MPstoughton/HB-Drive/HB_Drive_V1/Custom Components/54-00164/54-00164.step

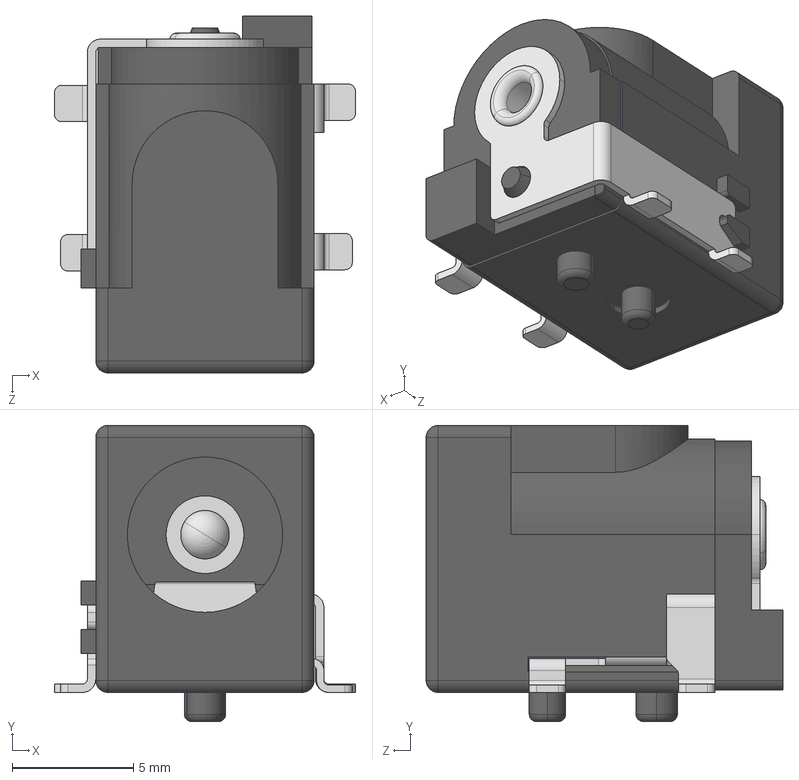
[picture p1: CAD file, 2026-06-23]
HB_Drive_V1/Custom Components/54-00164/54-00164.step
12.4 x 12.2 x 14.7 mm
