MPstoughton/HB-Drive/HB_Drive_V1/Custom Components/MMBD914LT3G/SOT-23_ONS.step

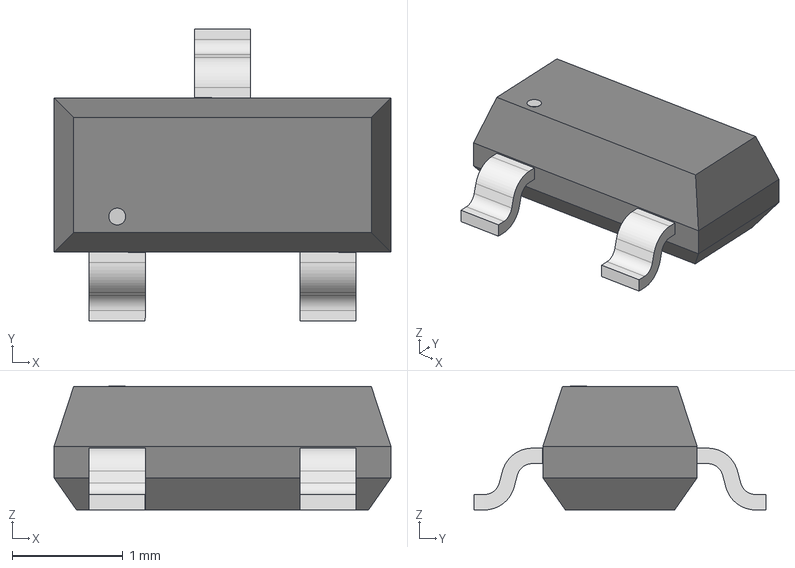
[picture p2: CAD file, 2026-06-23]
HB_Drive_V1/Custom Components/MMBD914LT3G/SOT-23_ONS.step
3.05 x 2.64 x 1.12 mm
