MPstoughton/HB-Drive/HB_Drive_V1/Custom Components/PTS636SL43SMTRLFS/PTS636SL43SMTRLFS.step

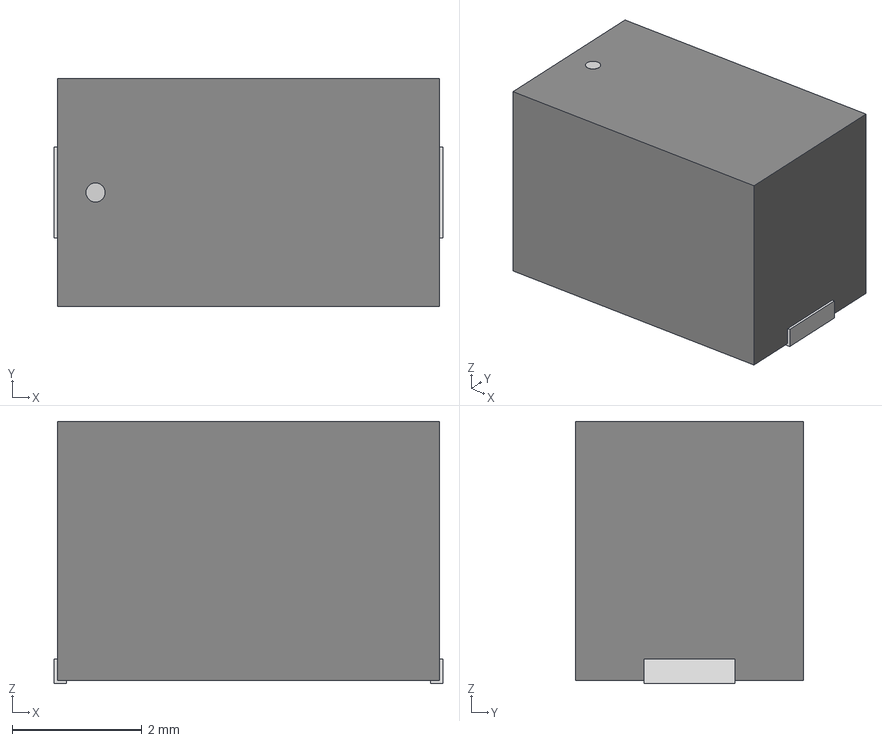
[picture p3: CAD file, 2026-07-07]
HB_Drive_V1/Custom Components/PTS636SL43SMTRLFS/PTS636SL43SMTRLFS.step
5.99 x 3.51 x 4.04 mm
