MPstoughton/HB-Drive/HB_Drive_V1/Custom Components/PV36W103C01B00/POT_PV36W_BRN.step

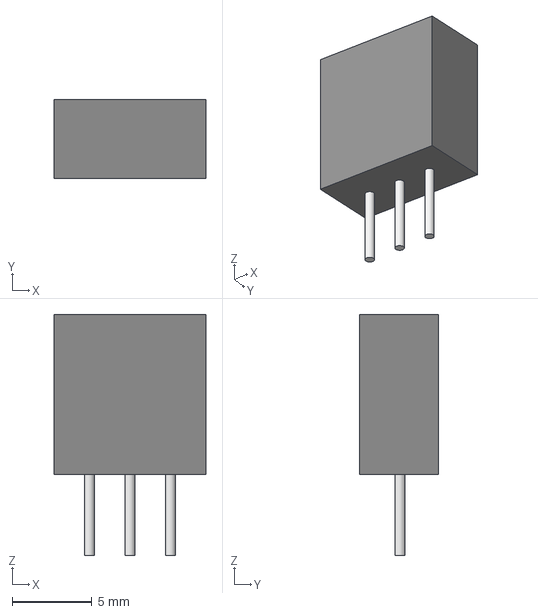
[picture p4: CAD file, 2026-06-23]
HB_Drive_V1/Custom Components/PV36W103C01B00/POT_PV36W_BRN.step
9.52 x 4.95 x 15.1 mm
