MPstoughton/HB-Drive/HB_Drive_V1/Custom Components/PV36W104C01B00/POT_PV36W_BRN.step

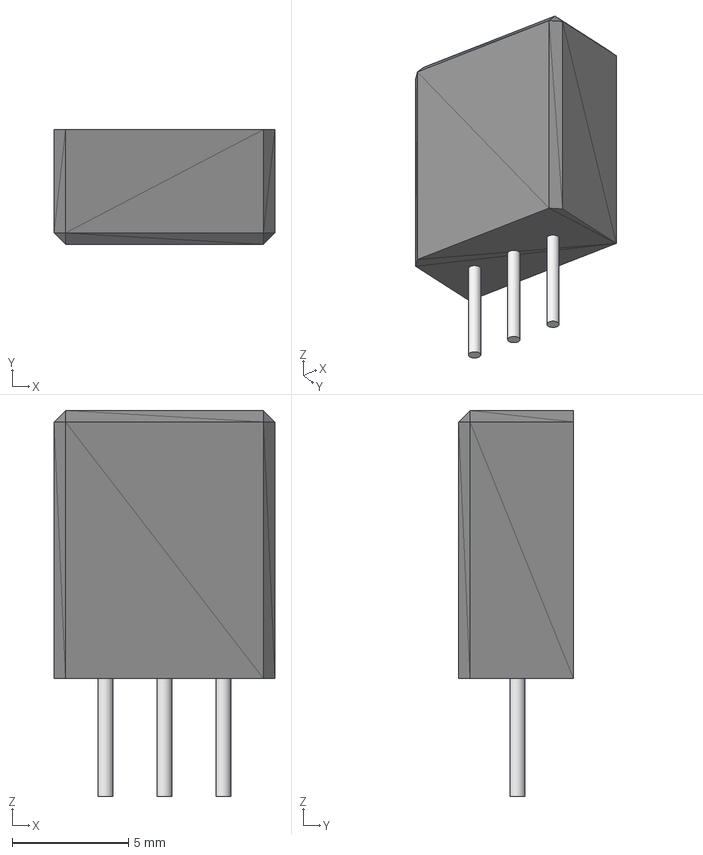
[picture p5: CAD file, 2026-06-12]
HB_Drive_V1/Custom Components/PV36W104C01B00/POT_PV36W_BRN.step
9.52 x 4.95 x 16.6 mm
