MPstoughton/HB-Drive/HB_Drive_V1/Custom Components/R_78E5_0_0_5/R_78E5_0_0_5.stp

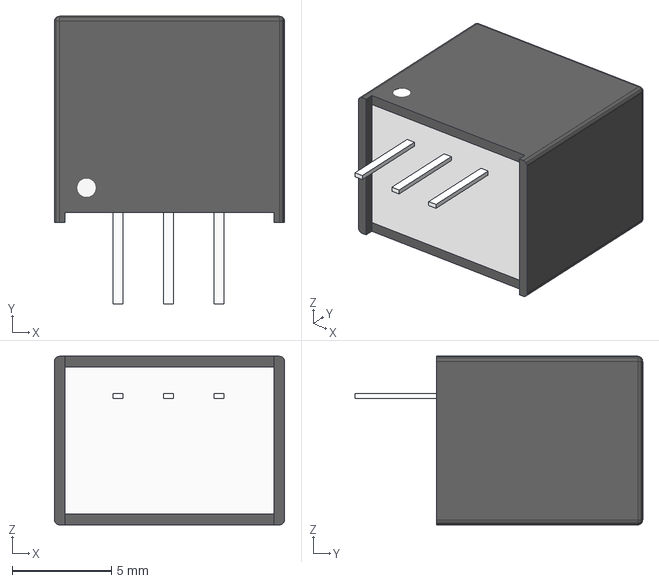
[picture p6: CAD file, 2026-07-03]
HB_Drive_V1/Custom Components/R_78E5_0_0_5/R_78E5_0_0_5.stp
11.6 x 14.5 x 8.51 mm
