MPstoughton/HB-Drive/HB_Drive_V1/Custom Components/TMH_0515D/tmh_single_3d_drawing.stp

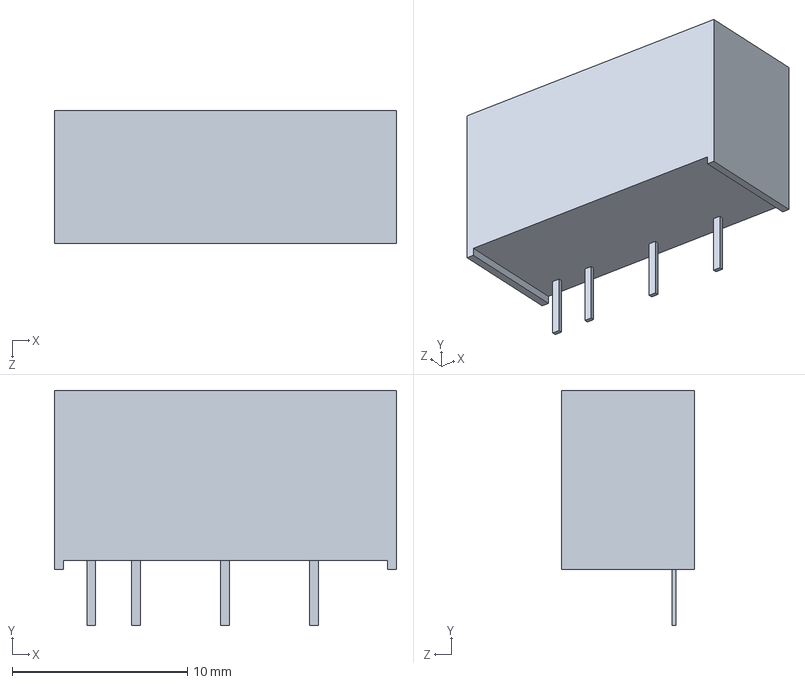
[picture p7: CAD file, 2026-07-03]
HB_Drive_V1/Custom Components/TMH_0515D/tmh_single_3d_drawing.stp
19.5 x 13.4 x 7.60 mm
