MPstoughton/HB-Drive/HB_Drive_V1/Custom Components/USB_B_S_VT/USB-B-S-VT.step

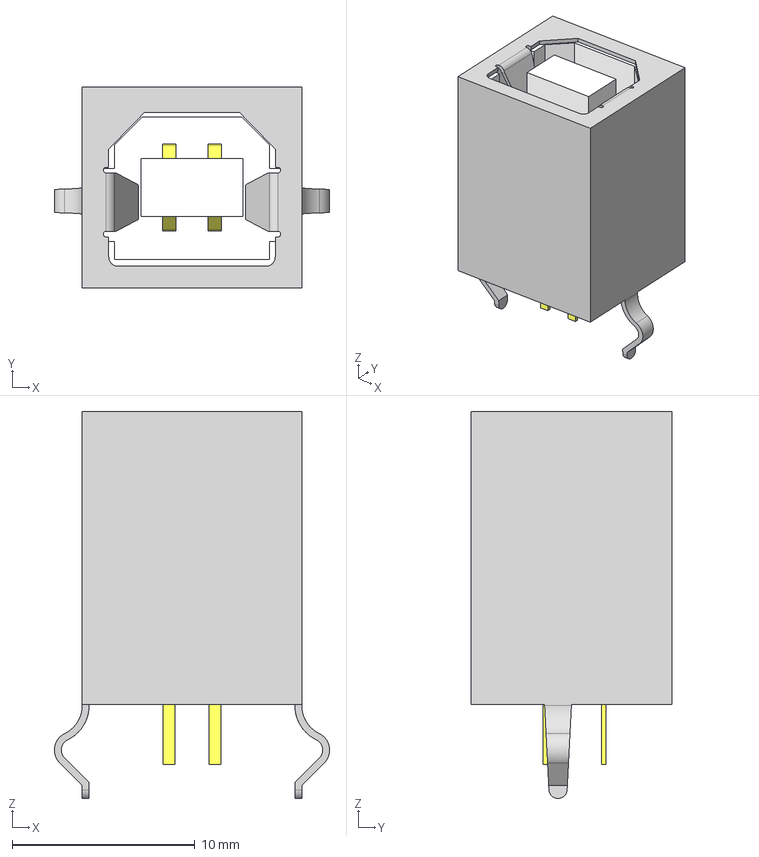
[picture p8: CAD file, 2026-07-03]
HB_Drive_V1/Custom Components/USB_B_S_VT/USB-B-S-VT.step
15.0 x 11.0 x 21.1 mm
USB-B-S-VT_S
USB-B-S-W-VT_B
USB-B-S-VT_P
