MPstoughton/HB-Drive/HB_V3_Plots/HB_Drive_V1-Edge_Cuts.dxf

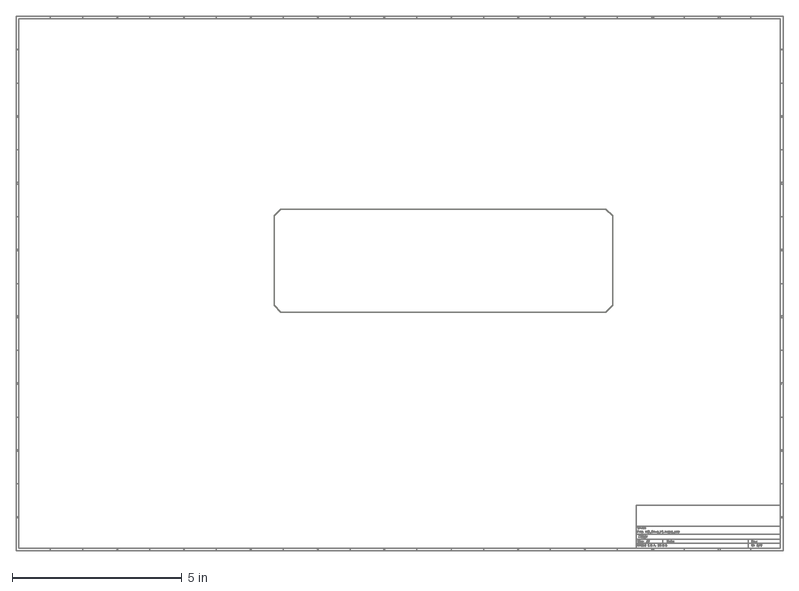
[picture p9: CAD file, 2026-10-09]
HB_V3_Plots/HB_Drive_V1-Edge_Cuts.dxf
22.6 x 15.7 in
