MPstoughton/HB-Drive/HB_Drive_V1/Custom Components/30306_6002/30306-6002HB.step

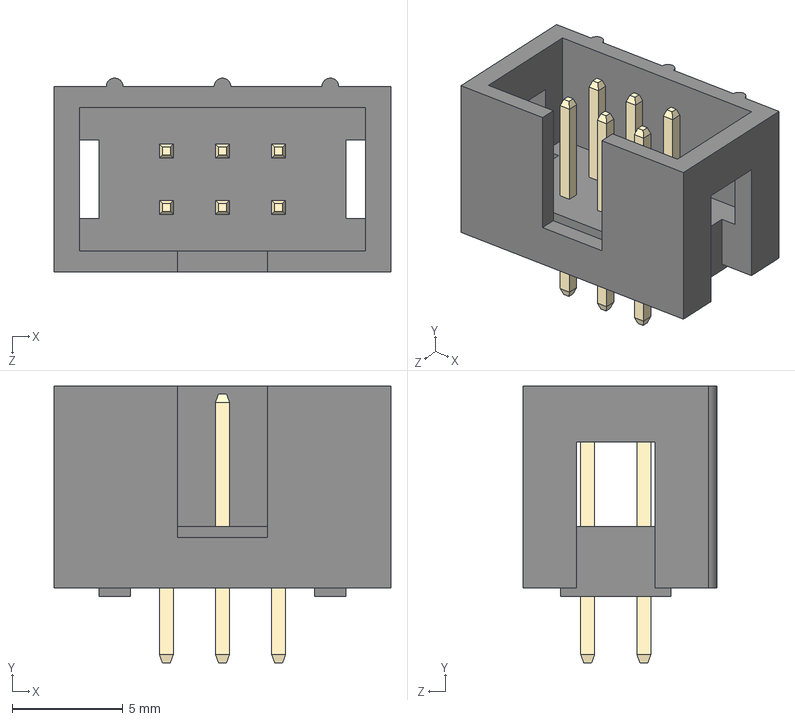
[picture p11: CAD file, 2026-08-12]
HB_Drive_V1/Custom Components/30306_6002/30306-6002HB.step
15.2 x 12.5 x 8.76 mm
