MPstoughton/HB-Drive/HB_Drive_V1/Custom Components/5227699/5227699-1.step

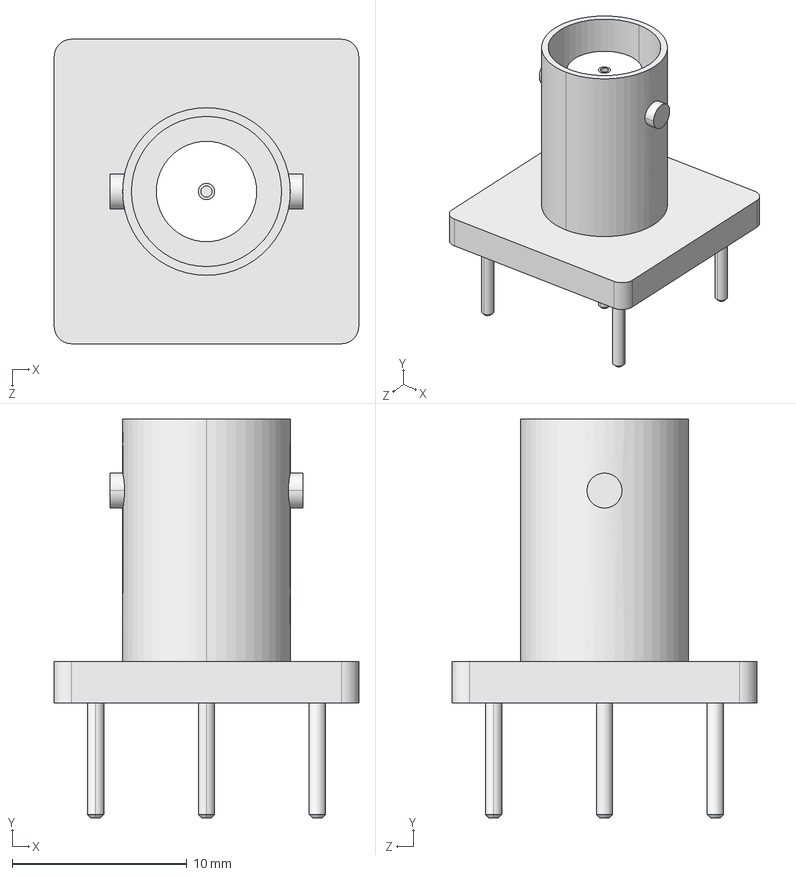
[picture p12: CAD file, 2026-07-03]
HB_Drive_V1/Custom Components/5227699/5227699-1.step
17.4 x 22.9 x 17.5 mm
