MPstoughton/HB-Drive/(list of files, cad)

Other CAD files:
HB_V3_Plots/HB_Drive_V1-F_Paste.dxf
