MPstoughton/HB-Drive/HB_Drive_V1/HB_Drive_V3.pdf

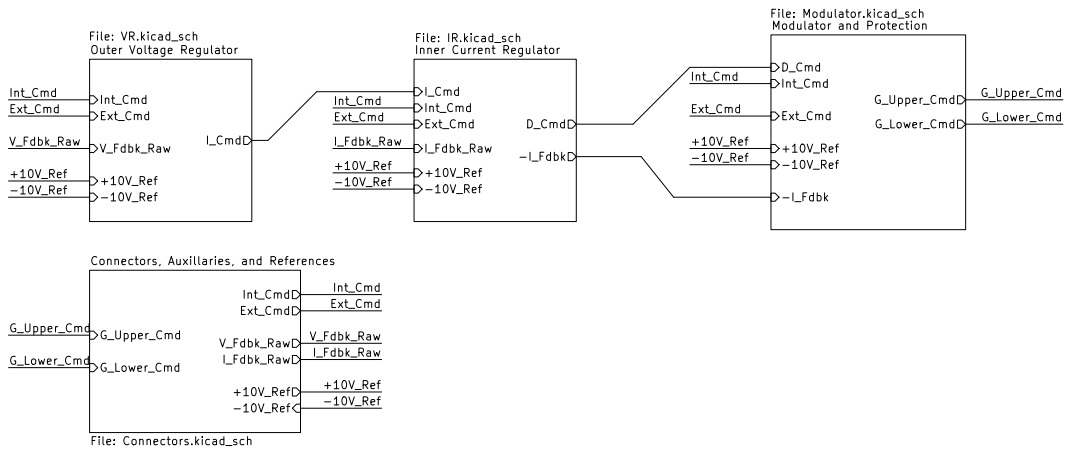
[picture p13: page 1]

Inner Current Regulator File: IR.kicad_sch

Connectors, Auxillaries, and References File: Connectors.kicad_sch

Size: A4 | Rev:
KiCad E.D.A. 10.0.5 | Id: 1/8

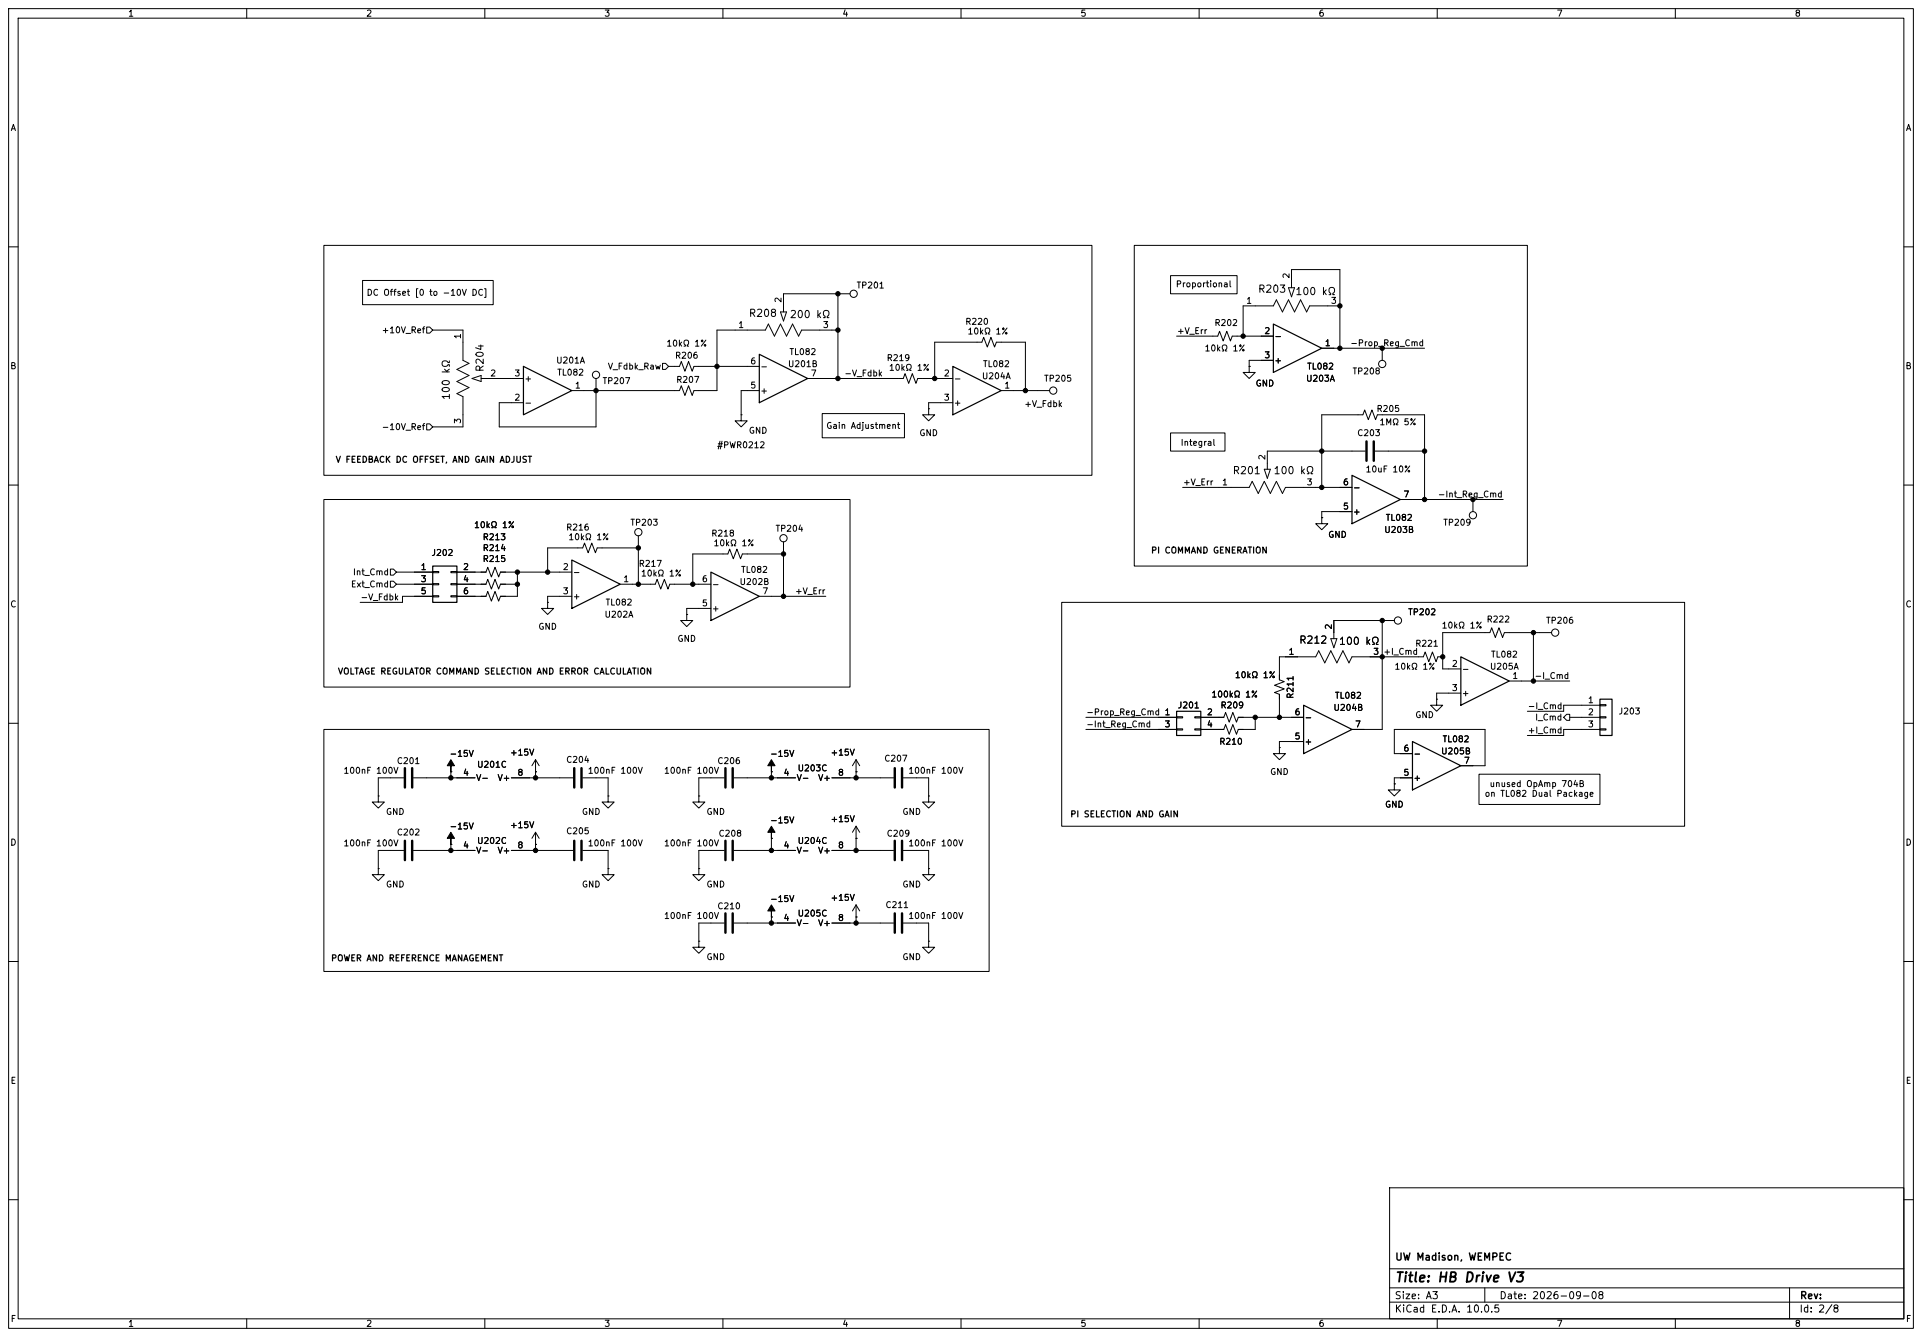
[picture p14: page 2]

Gain Adjustment VOLTAGE REGULATOR COMMAND SELECTION AND ERROR CALCULATION

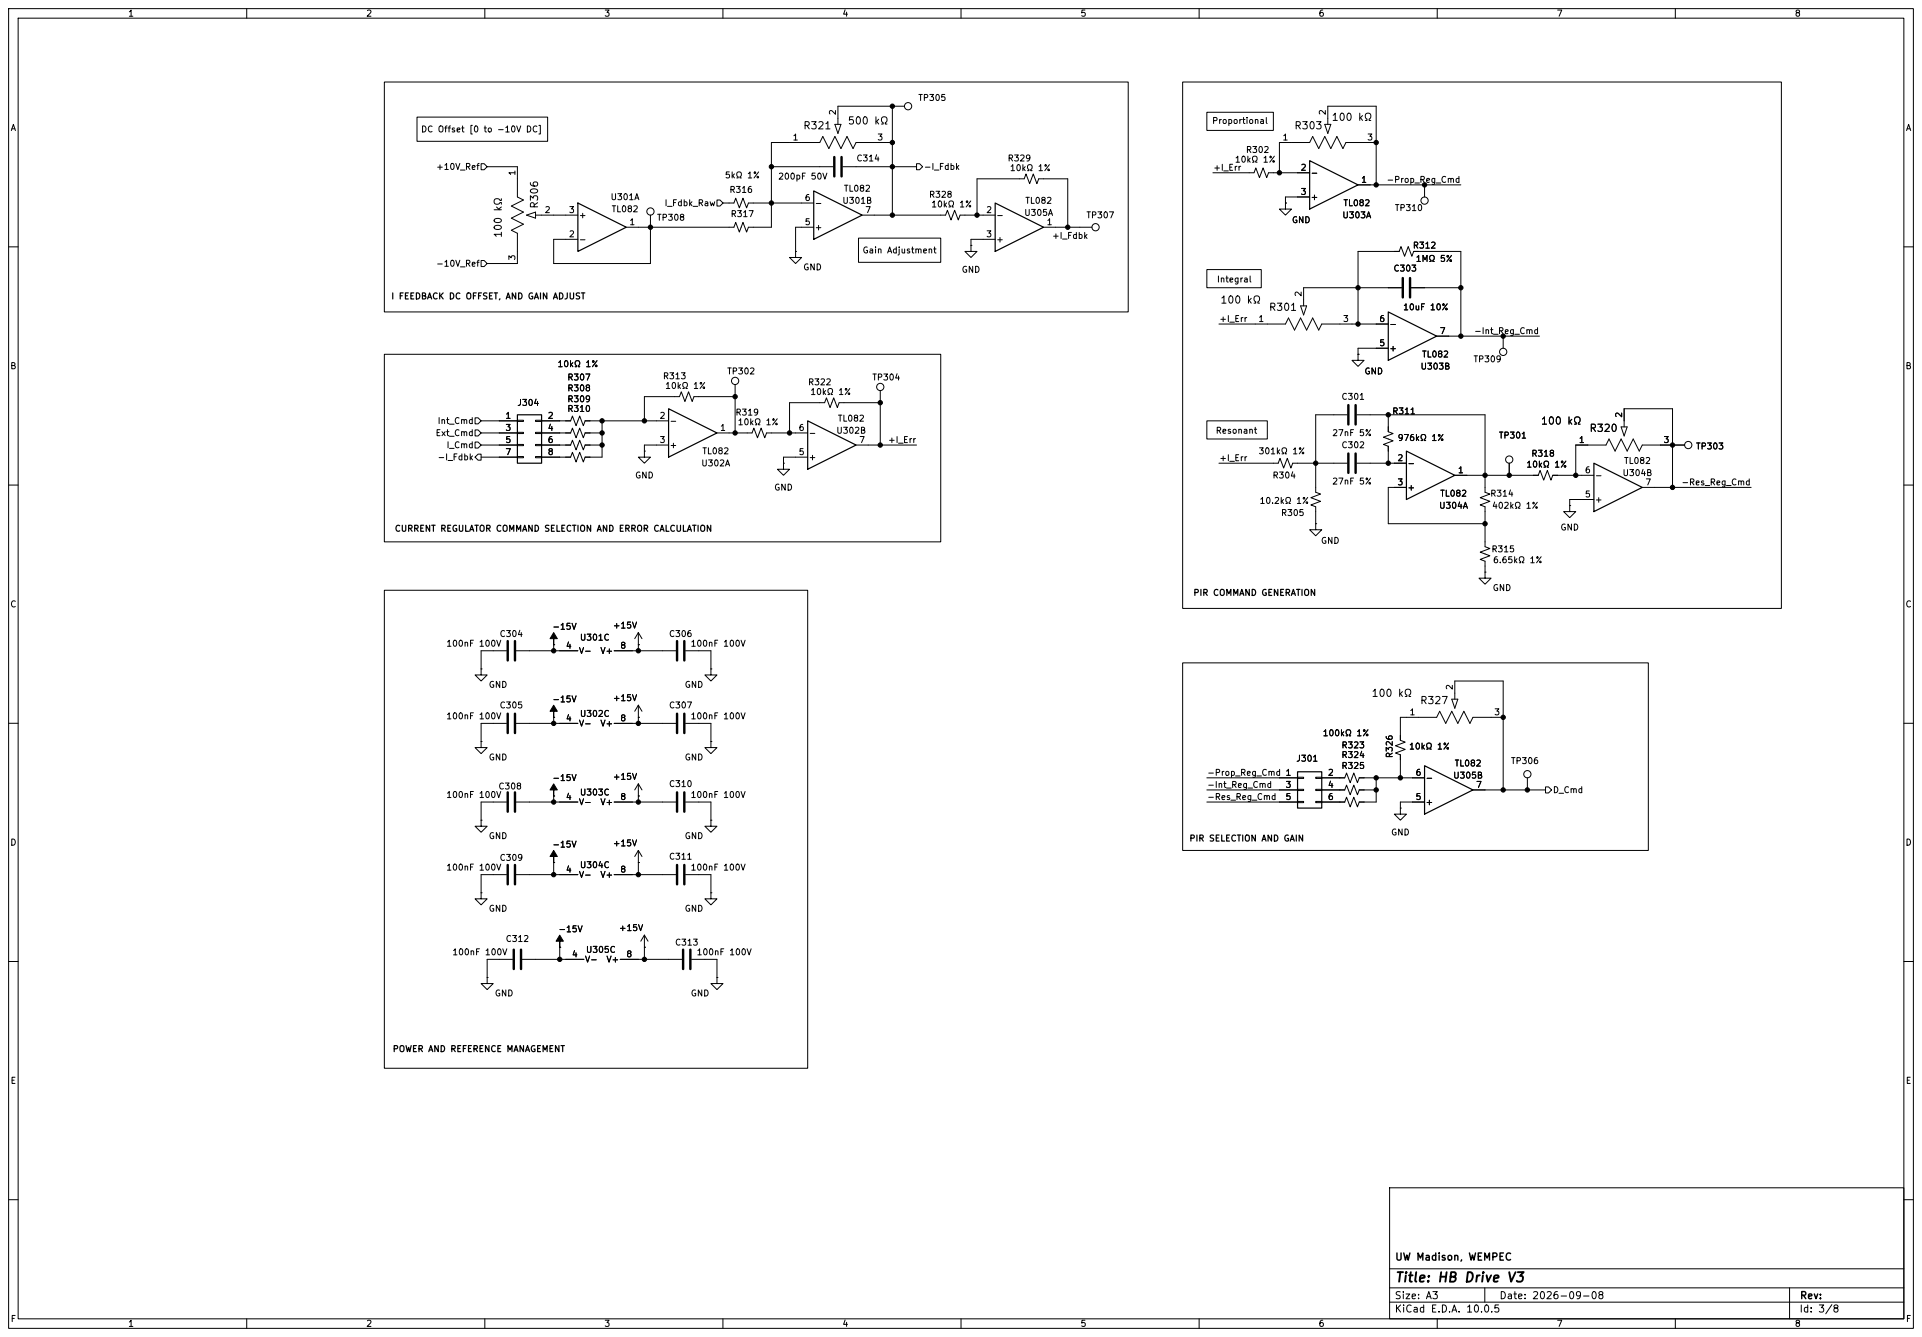
[picture p15: page 3]

Proportional DC Offset [0 to -10V DC]
-10V_Ref Ext_Cmd +10V_Ref

-Int_Reg_Cmd +I_Err +I_Err CURRENT REGULATOR COMMAND SELECTION AND ERROR CALCULATION

POWER AND REFERENCE MANAGEMENT

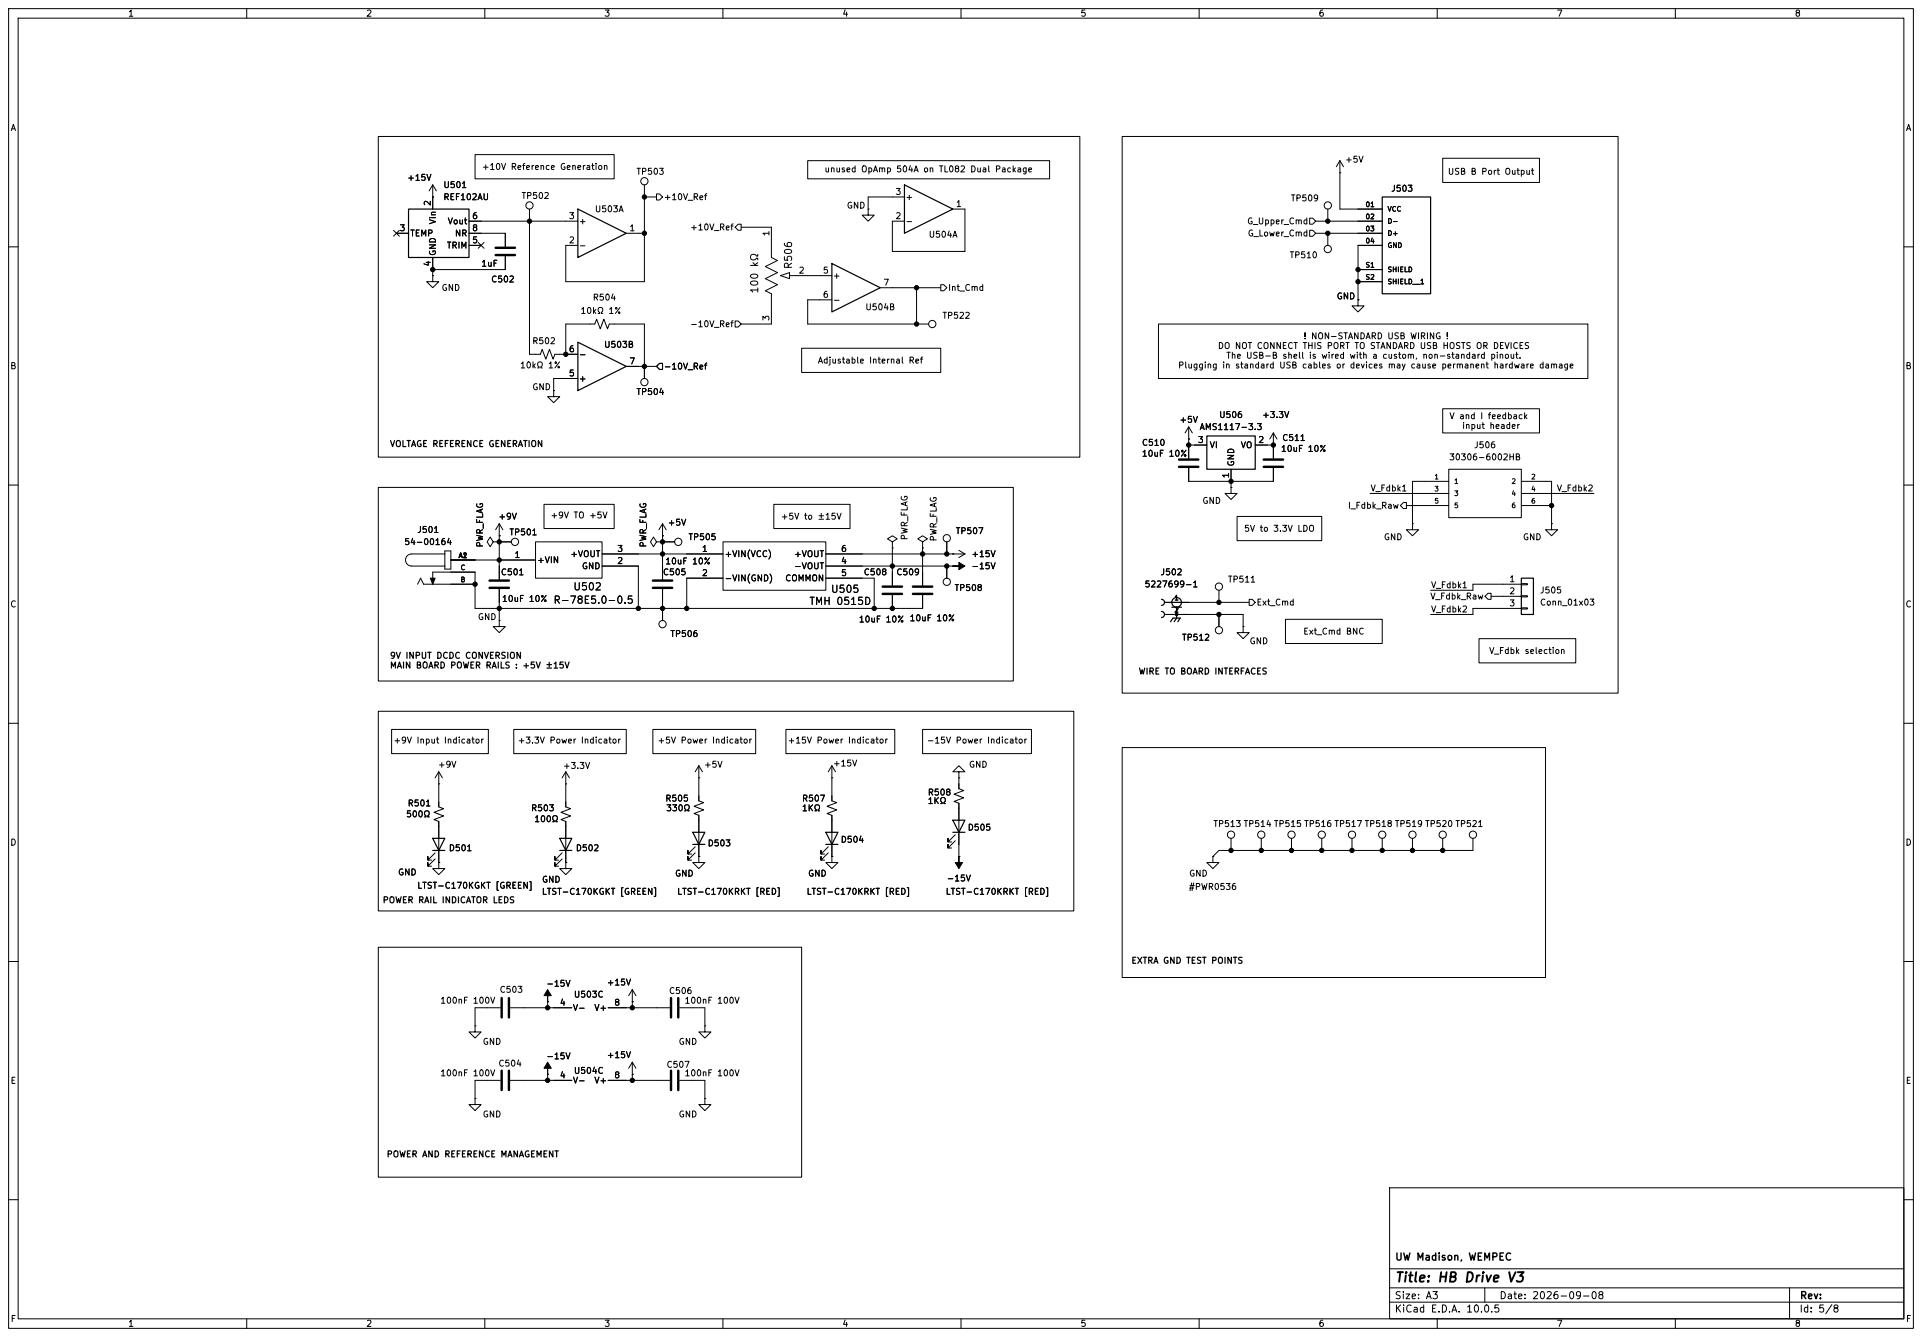
[picture p16: page 4]

9V INPUT DCDC CONVERSION MAIN BOARD POWER RAILS : +5V ±15V +10V Reference Generation +3.3V Power Indicator
U501 REF102AU Vin 2

! NON-STANDARD USB WIRING ! DO NOT CONNECT THIS PORT TO STANDARD USB HOSTS OR DEVICES

The USB-B shell is wired with a custom, non-standard pinout.

Plugging in standard USB cables or devices may cause permanent hardware damage

EXTRA GND TEST POINTS

POWER AND REFERENCE MANAGEMENT

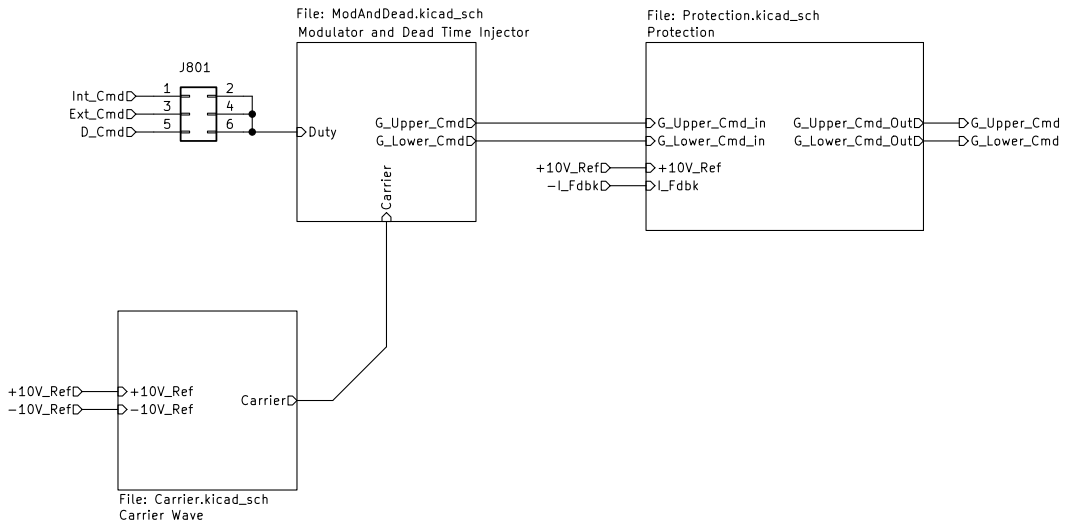
[picture p17: page 5]

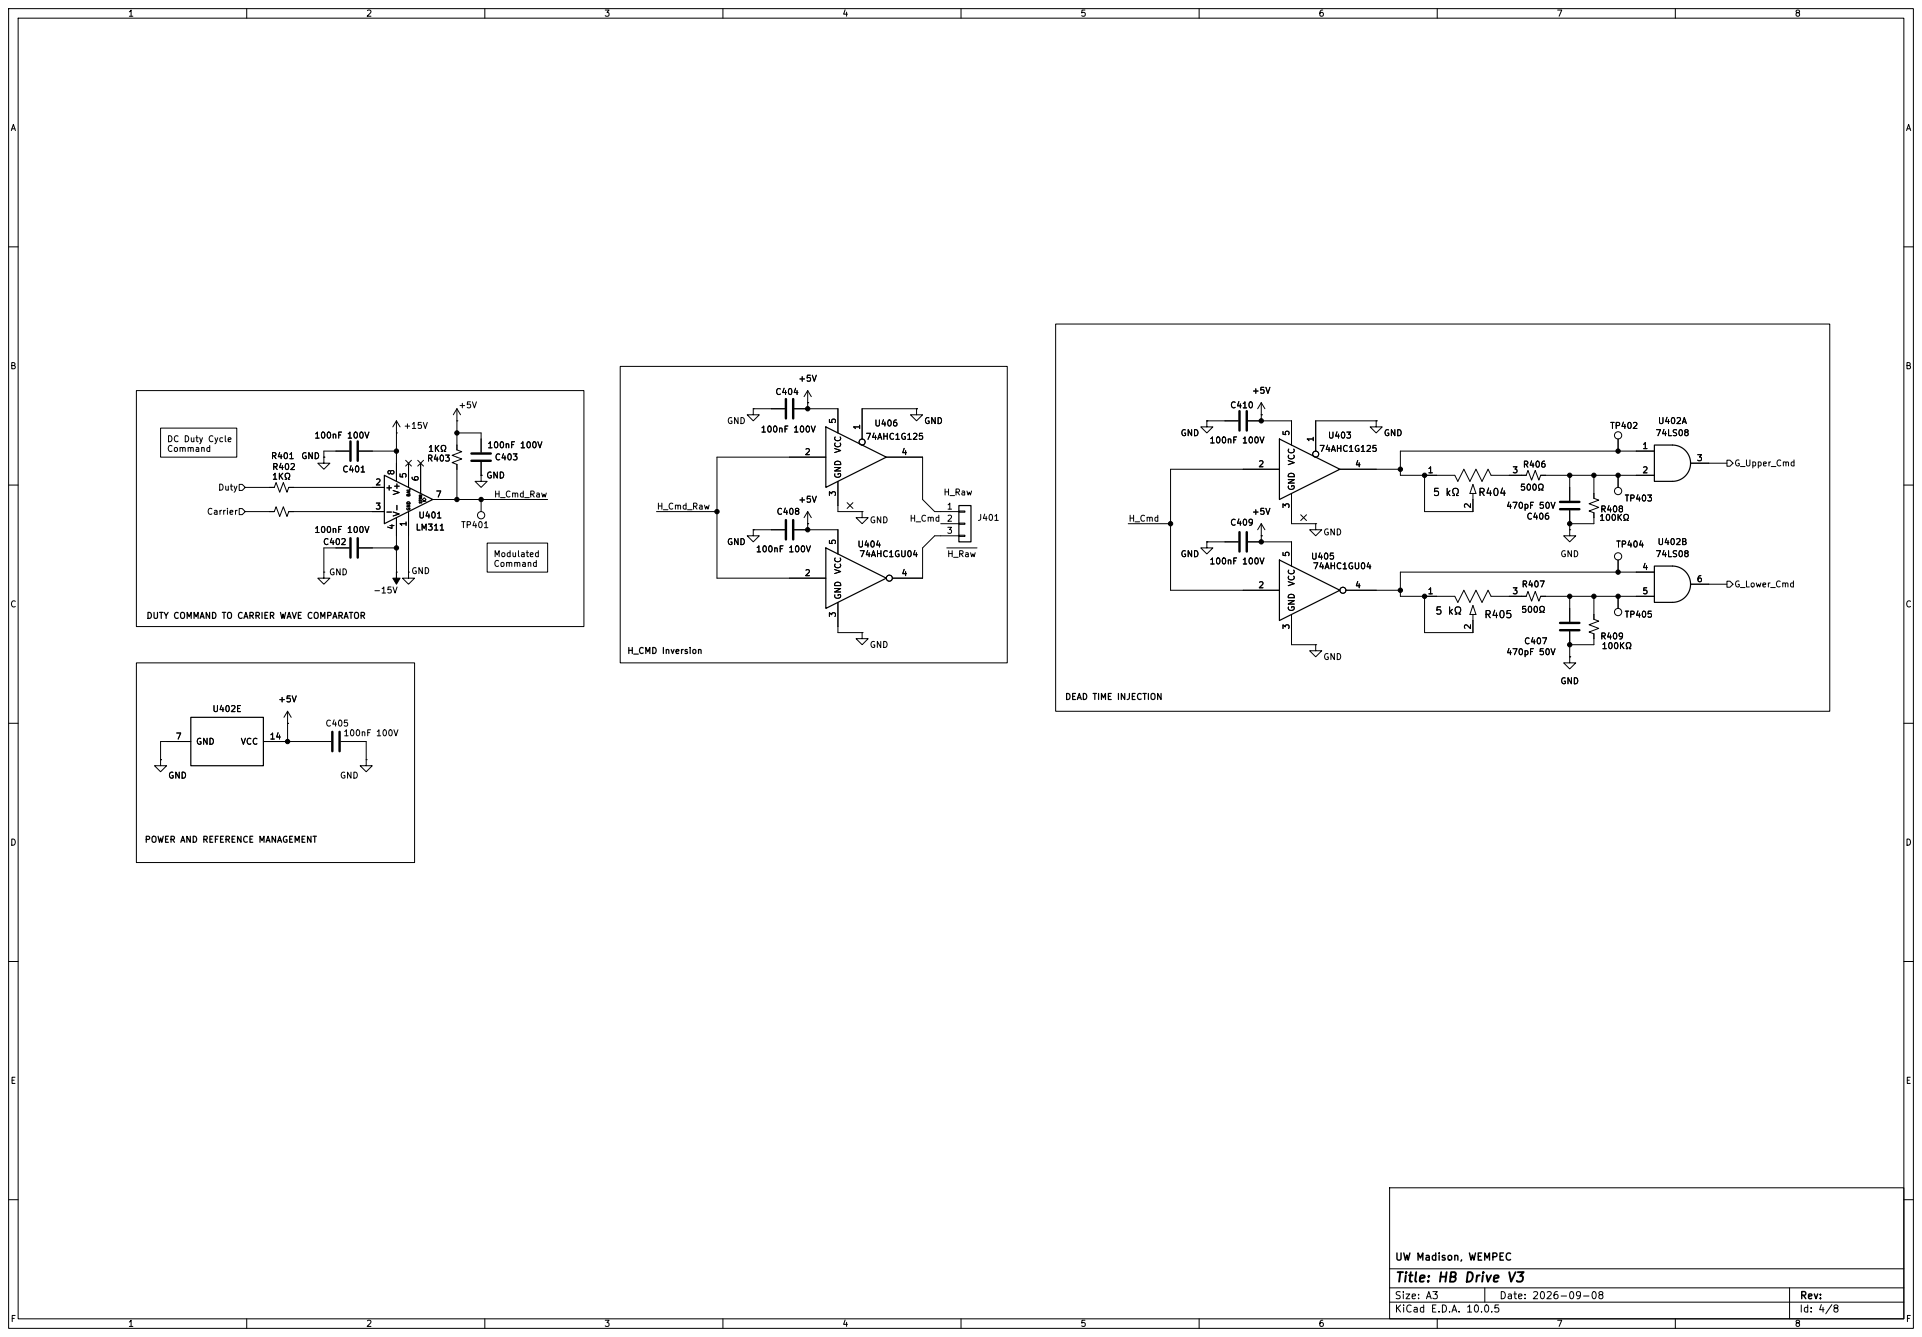
[picture p18: page 6]

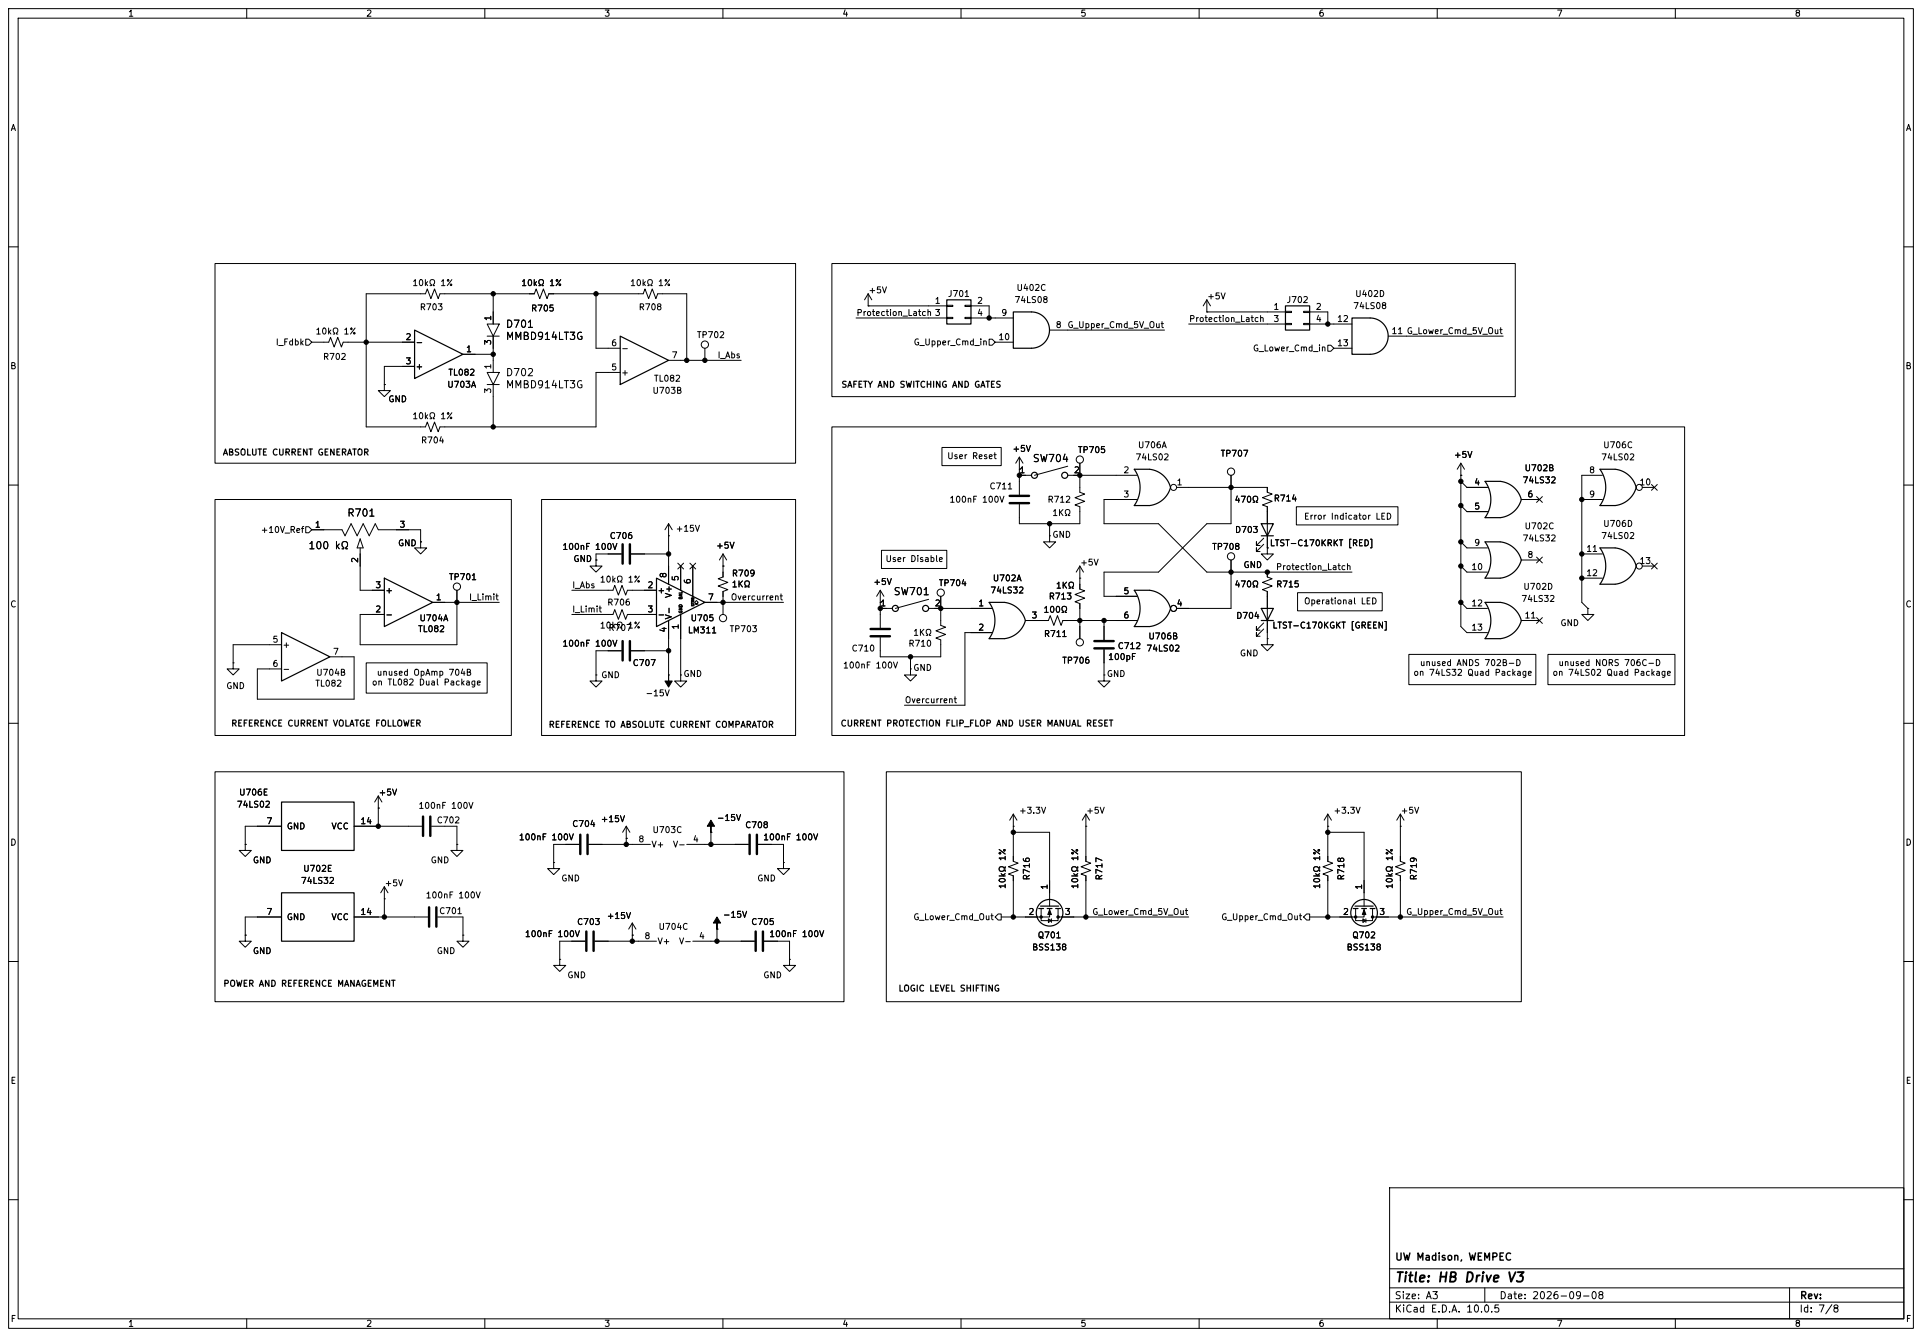
[picture p19: page 7]

unused NORS 706C-D on 74LS02 Quad Package +5V SW704

Error Indicator LED User Reset

unused ANDS 702B-D on 74LS32 Quad Package REFERENCE CURRENT VOLATGE FOLLOWER

unused OpAmp 704B on TL082 Dual Package

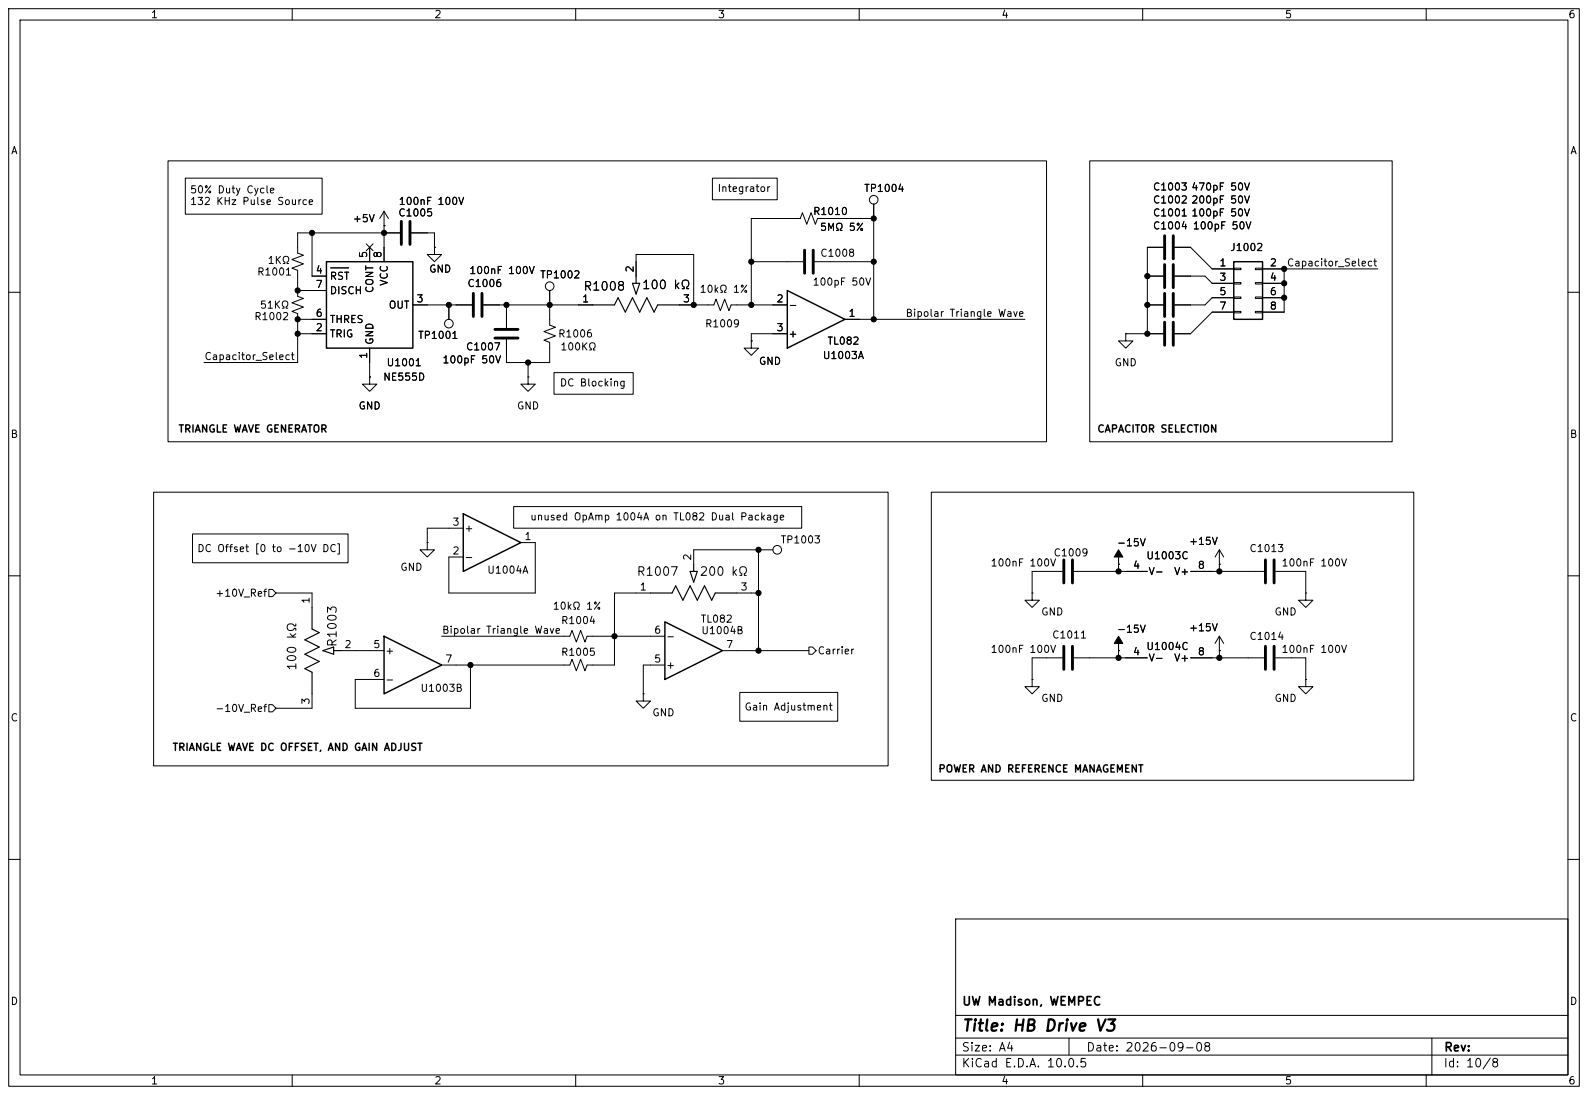
[picture p20: page 8]

Integrator TRIANGLE WAVE GENERATOR
