MPstoughton/HB-Drive/HB_Drive_V1/HB_Drive_V1.kicad_pcb

## KiCad design HB_Drive_V1/HB_Drive_V1.kicad_pcb (2026-10-09)

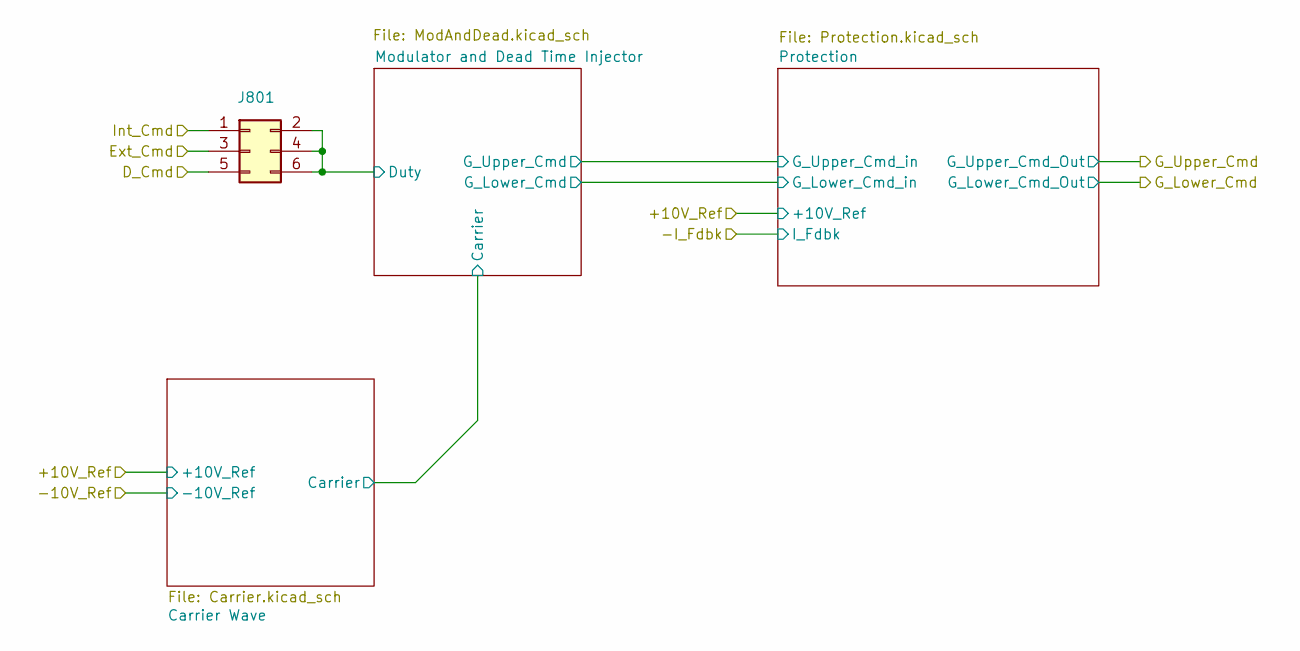
[picture p21: schematic Modulator.kicad_sch, HB Drive V3]

Parts:
J801: Conn_02x03_Odd_Even; PinHeader_2x03_P2.54mm_Vertical

Connections:
/Ext_Cmd: J801.3; also elsewhere on the board
/Inner Current Regulator/D_Cmd: J801.5; also elsewhere on the board
/Int_Cmd: J801.1; also elsewhere on the board
/Modulator and Protection/Modulator and Dead Time Injector/Duty: J801.2, J801.4, J801.6; also elsewhere on the board

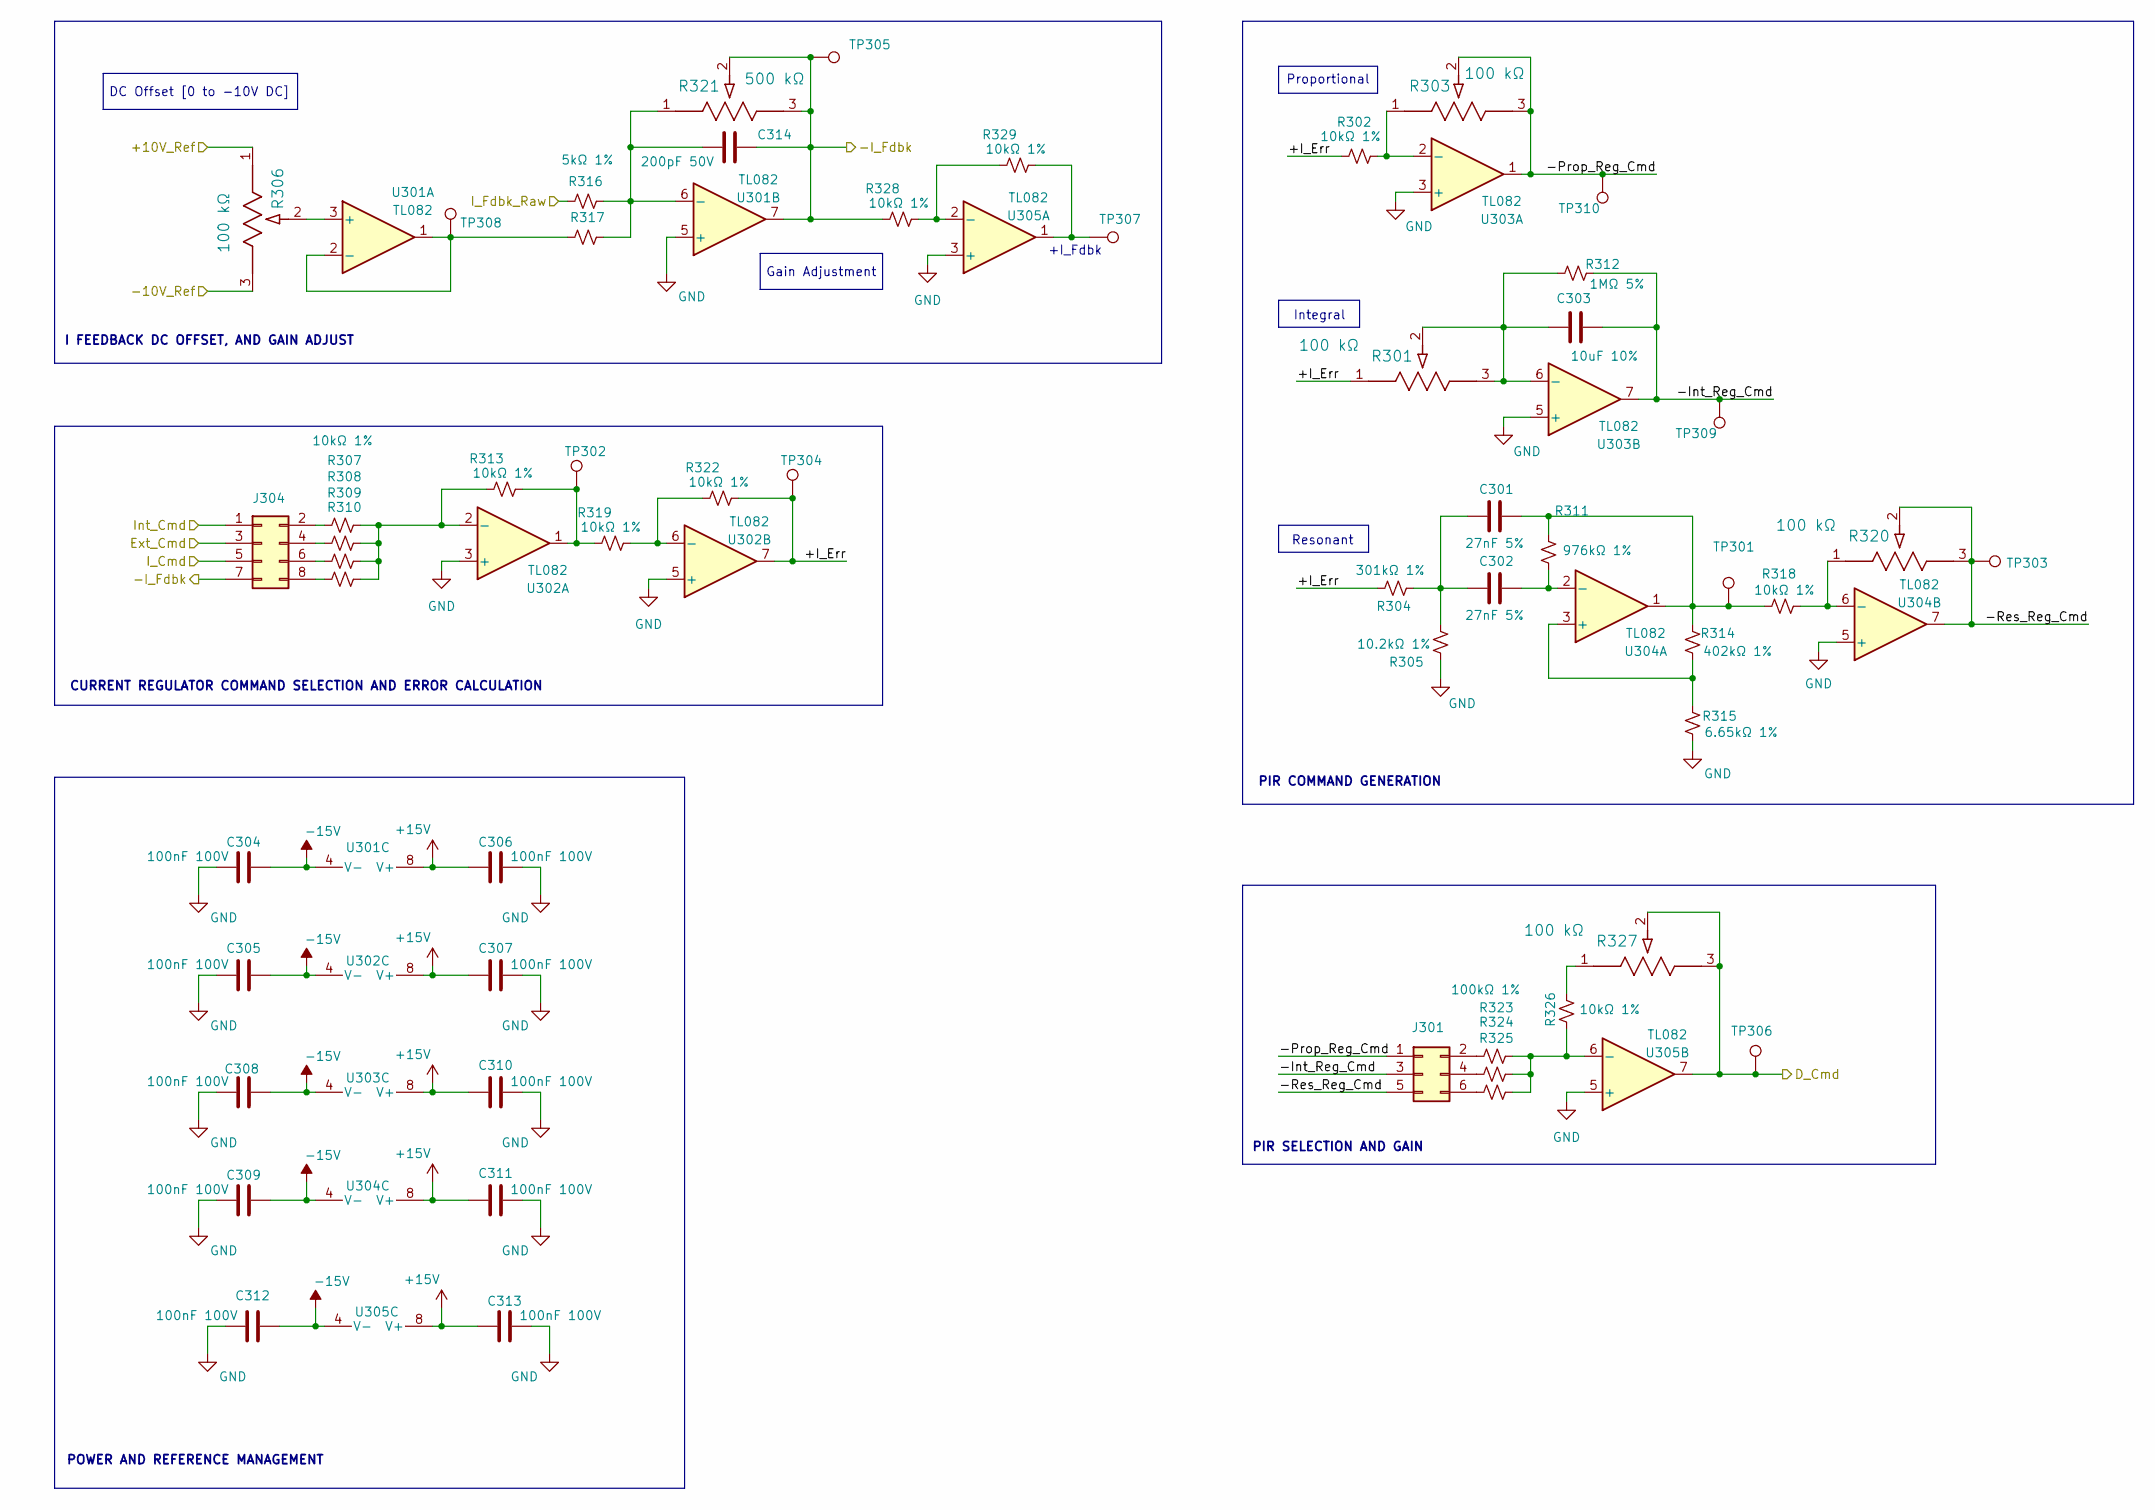
[picture p22: schematic IR.kicad_sch, HB Drive V3]

Parts:
C301, C302: 27nF 5%; C_0603_1608Metric
C303: 10uF 10%; C_0603_1608Metric
C304, C305, C306, C307, C308, C309, C310, C311, C312, C313: 100nF 100V; C_0603_1608Metric
C314: 200pF 50V; C_0603_1608Metric
J301: Conn_02x03_Odd_Even; PinHeader_2x03_P2.54mm_Vertical
J304: Conn_02x04_Odd_Even; PinHeader_2x04_P2.54mm_Vertical
R301, R303, R306, R320, R327: 100 kΩ; POT_PV36W_BRN
R302, R307, R308, R309, R310, R313, R318, R319, R322, R326, R328, R329: 10kΩ 1%; R_0603_1608Metric_Pad0.98x0.95mm_HandSolder
R304: 301kΩ 1%; R_0603_1608Metric_Pad0.98x0.95mm_HandSolder
R305: 10.2kΩ 1%; R_0603_1608Metric_Pad0.98x0.95mm_HandSolder
R311: 976kΩ 1%; R_0603_1608Metric_Pad0.98x0.95mm_HandSolder
R312: 1MΩ 5%; R_0603_1608Metric_Pad0.98x0.95mm_HandSolder
R314: 402kΩ 1%; R_0603_1608Metric_Pad0.98x0.95mm_HandSolder
R315: 6.65kΩ 1%; R_0603_1608Metric_Pad0.98x0.95mm_HandSolder
R316, R317: 5kΩ 1%; R_0603_1608Metric_Pad0.98x0.95mm_HandSolder
R321: 500 kΩ; POT_PV36W_BRN
R323, R324, R325: 100kΩ 1%; R_0603_1608Metric_Pad0.98x0.95mm_HandSolder
TP301, TP302, TP303, TP304, TP305, TP306, TP307, TP308, TP309, TP310: TestPoint; TestPoint_Loop_D2.60mm_Drill1.6mm_Beaded
U301, U302, U303, U304, U305: TL082; SOIC-8_3.9x4.9mm_P1.27mm

Connections:
+15V: C306.2, C307.2, C310.2, C311.2, C313.2, U301.8 (V+), U302.8 (V+), U303.8 (V+), U304.8 (V+), U305.8 (V+); also elsewhere on the board
-15V: C304.1, C305.1, C308.1, C309.1, C312.1, U301.4 (V-), U302.4 (V-), U303.4 (V-), U304.4 (V-), U305.4 (V-); also elsewhere on the board
/+10V_Ref: R306.1; also elsewhere on the board
/-10V_Ref: R306.3; also elsewhere on the board
/Ext_Cmd: J304.3; also elsewhere on the board
/I_Fdbk_Raw: R316.2; also elsewhere on the board
/Inner Current Regulator/+I_Err: R301.1, R302.1, R304.2, R322.1, TP304.1 (1_1), U302.7
/Inner Current Regulator/-I_Fdbk: C314.1, J304.7, R321.2, R321.3, R328.2, TP305.1 (1_1), U301.7; also elsewhere on the board
/Inner Current Regulator/-Int_Reg_Cmd: C303.1, J301.3, R312.2, TP309.1 (1_1), U303.7
/Inner Current Regulator/-Prop_Reg_Cmd: J301.1, R303.2, R303.3, TP310.1 (1_1), U303.1
/Inner Current Regulator/-Res_Reg_Cmd: J301.5, R320.2, R320.3, TP303.1 (1_1), U304.7
/Inner Current Regulator/D_Cmd: R327.2, R327.3, TP306.1 (1_1), U305.7; also elsewhere on the board
/Inner Current Regulator/I_Cmd: J304.5; also elsewhere on the board
/Int_Cmd: J304.1; also elsewhere on the board
GND: C304.2, C305.2, C306.1, C307.1, C308.2, C309.2, C310.1, C311.1, C312.2, C313.1, R305.2, R315.1, U301.5 (+), U302.3 (+), U302.5 (+), U303.3 (+), U303.5 (+), U304.5 (+), U305.3 (+), U305.5 (+); also elsewhere on the board
unnamed: C301.1, R311.2, R314.2, R318.2, TP301.1 (1_1), U304.1
unnamed: C301.2, C302.2, R304.1, R305.1
unnamed: J301.2, R323.2
unnamed: J301.4, R324.2
unnamed: J301.6, R325.2
unnamed: J304.2, R307.2
unnamed: J304.4, R308.1
unnamed: J304.6, R309.1
unnamed: J304.8, R310.1
unnamed: R313.1, R319.2, TP302.1 (1_1), U302.1
unnamed: R326.2, R327.1
unnamed: R329.1, TP307.1 (1_1), U305.1
unnamed: R306.2, U301.3 (+)
unnamed: R317.2, TP308.1 (1_1), U301.1, U301.2 (-)
unnamed: C314.2, R316.1, R317.1, R321.1, U301.6 (-)
unnamed: R307.1, R308.2, R309.2, R310.2, R313.2, U302.2 (-)
unnamed: R319.1, R322.2, U302.6 (-)
unnamed: R302.2, R303.1, U303.2 (-)
unnamed: C303.2, R301.2, R301.3, R312.1, U303.6 (-)
unnamed: R314.1, R315.2, U304.3 (+)
unnamed: C302.1, R311.1, U304.2 (-)
unnamed: R318.1, R320.1, U304.6 (-)
unnamed: R328.1, R329.2, U305.2 (-)
unnamed: R323.1, R324.1, R325.1, R326.1, U305.6 (-)

Notes on the sheet:
DC Offset [0 to -10V DC]
CURRENT REGULATOR COMMAND SELECTION AND ERROR CALCULATION
Proportional
Resonant
PIR COMMAND GENERATION
I FEEDBACK DC OFFSET, AND GAIN ADJUST
+I_Fdbk
POWER AND REFERENCE MANAGEMENT
PIR SELECTION AND GAIN
Integral
Gain Adjustment

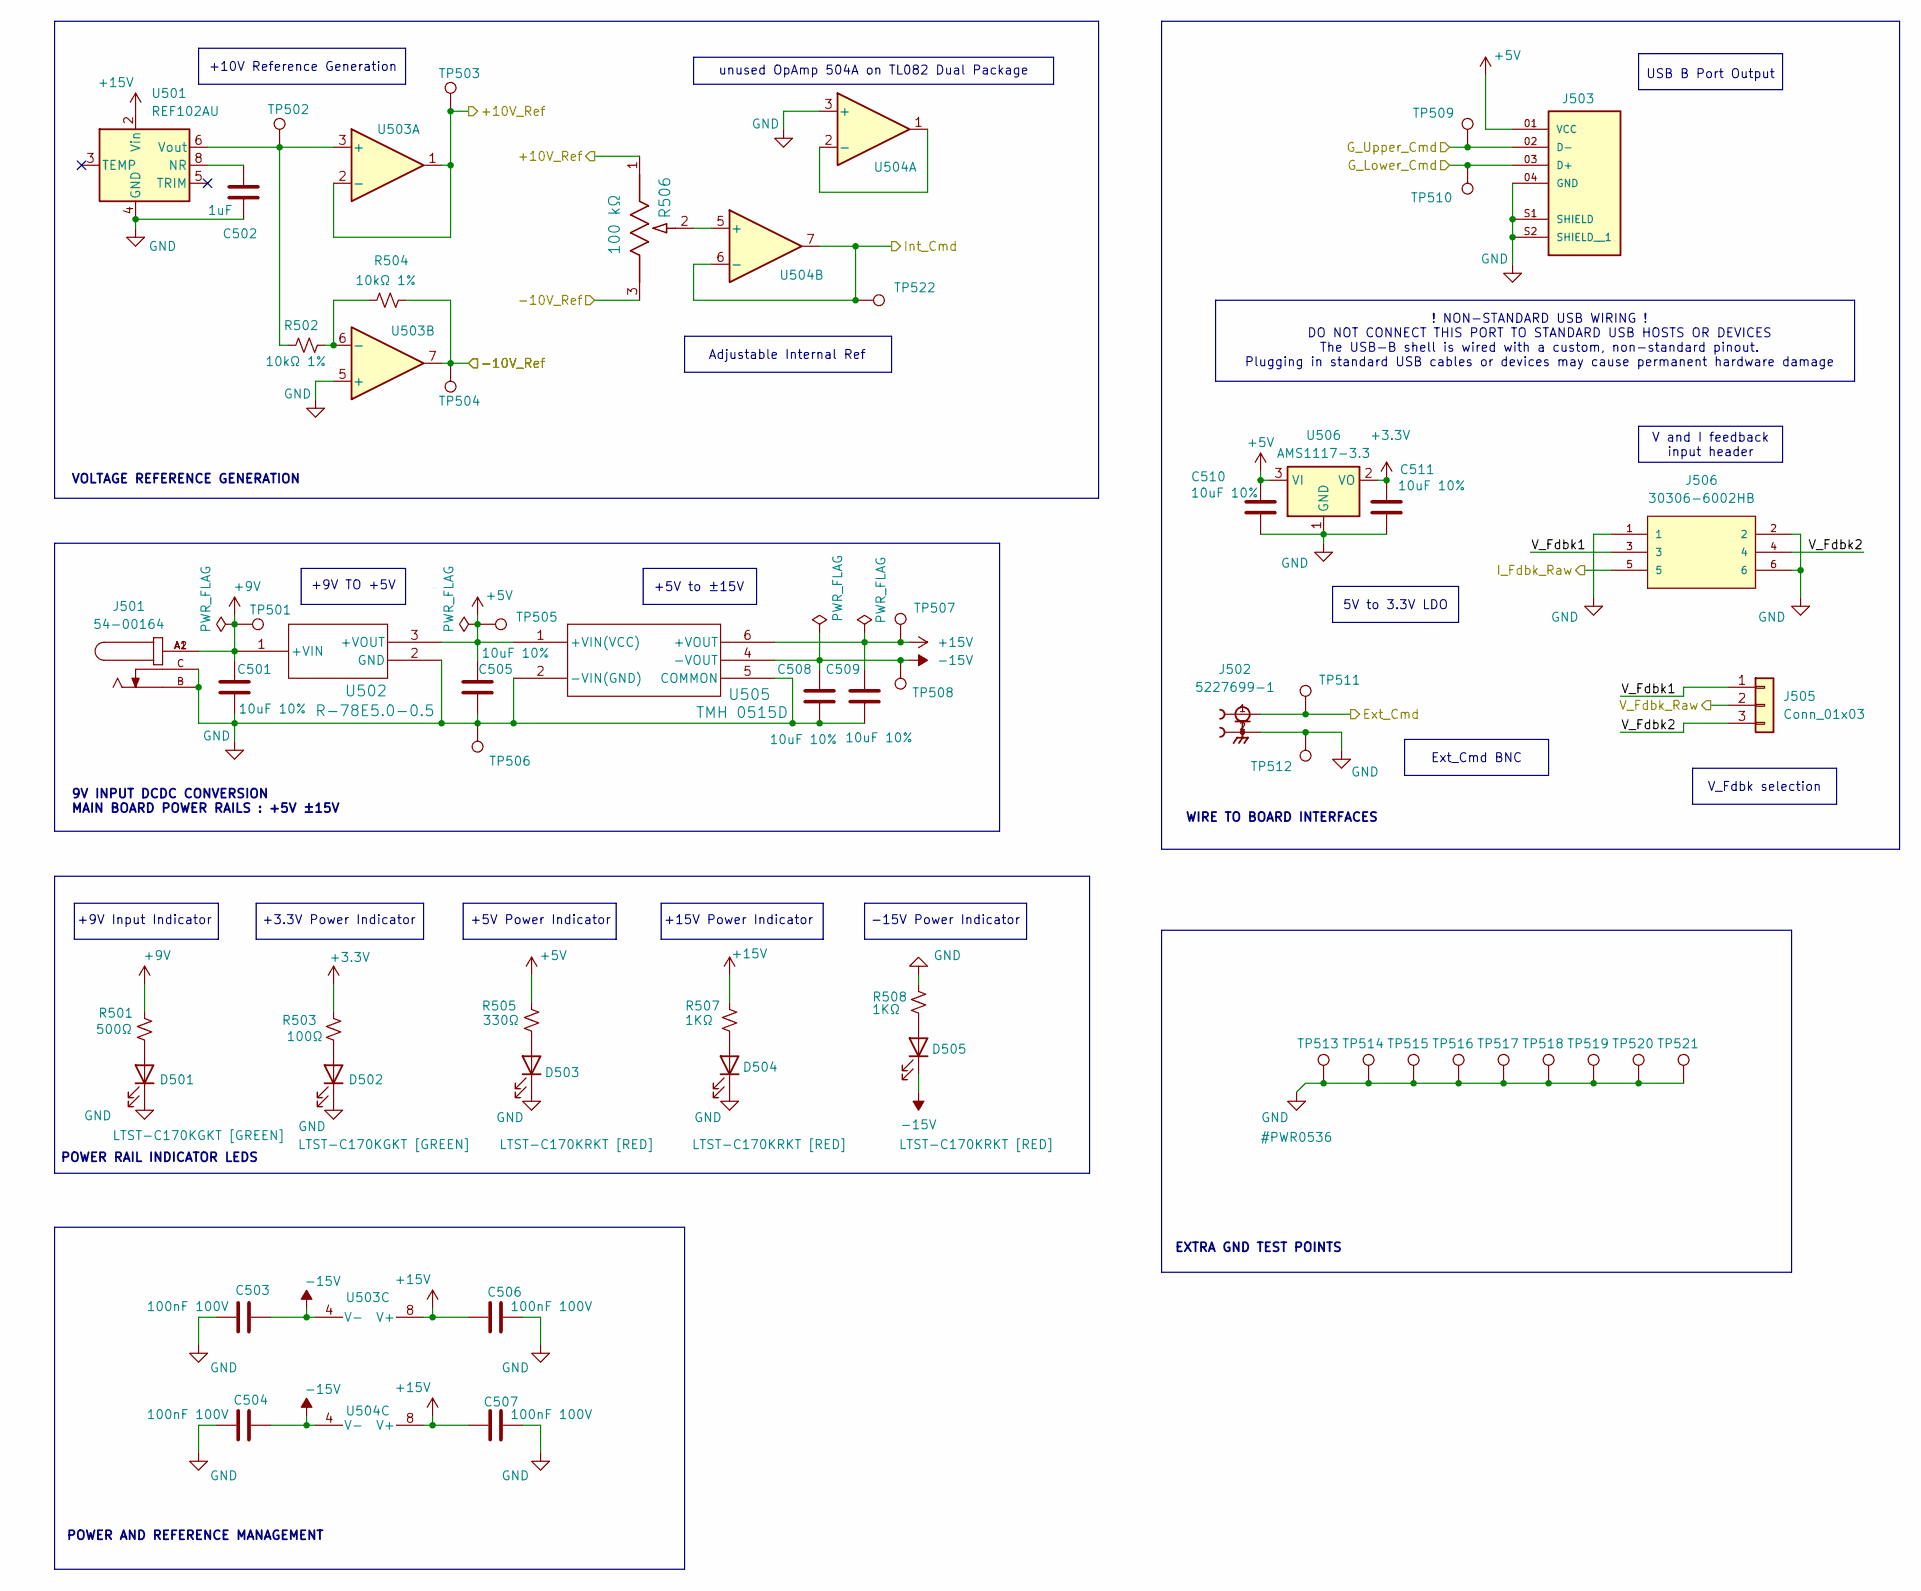
[picture p23: schematic Connectors.kicad_sch, HB Drive V3]

Parts:
C501, C505, C508, C509, C510, C511: 10uF 10%; C_0603_1608Metric
C502: 1uF; C_0603_1608Metric
C503, C504, C506, C507: 100nF 100V; C_0603_1608Metric
D501, D502: LTST-C170KGKT [GREEN]; LED_0805_2012Metric_Pad1.15x1.40mm_HandSolder
D503, D504, D505: LTST-C170KRKT [RED]; LED_0805_2012Metric_Pad1.15x1.40mm_HandSolder
J501: 54-00164; TENSILITY_54-00164; PARTREV A
J502: 5227699-1; TE_5227699-1; PARTREV A; DigiKey_Part_Number A33798-ND
J503: USB-B-S-X-X-VT; USB-B-S-VT; PARTREV Q
J505: Conn_01x03; PinHeader_1x03_P2.54mm_Vertical
J506: 30306-6002HB
R501: 500Ω; R_0603_1608Metric_Pad0.98x0.95mm_HandSolder
R502, R504: 10kΩ 1%; R_0603_1608Metric_Pad0.98x0.95mm_HandSolder
R503: 100Ω; R_0603_1608Metric_Pad0.98x0.95mm_HandSolder
R505: 330Ω; R_0603_1608Metric_Pad0.98x0.95mm_HandSolder
R506: 100 kΩ; POT_PV36W_BRN
R507, R508: 1KΩ; R_0603_1608Metric_Pad0.98x0.95mm_HandSolder
TP501, TP502, TP503, TP504, TP505, TP506, TP507, TP508, TP509, TP510, TP511, TP512, TP513, TP514, TP515, TP516, TP517, TP518, TP519, TP520, TP521, TP522: TestPoint; TestPoint_Loop_D2.60mm_Drill1.6mm_Beaded
U501: REF102AU; SOIC-8_3.9x4.9mm_P1.27mm
U502: R-78E5.0-0.5; R_78E_0.5_RCP
U503, U504: TL082; SOIC-8_3.9x4.9mm_P1.27mm
U505: TMH 0515D; TMH DUAL_TRP
U506: AMS1117-3.3; SOT-223-3_TabPin2

Connections:
+3.3V: C511.1, R503.2, U506.2 (VO); also elsewhere on the board
+5V: C505.1, C510.1, J503.01 (VCC), R505.2, TP505.1 (1_1), U502.3 (+VOUT), U505.1 (+VIN(VCC)), U506.3 (VI); also elsewhere on the board
+9V: C501.1, J501.A1, J501.A2, R501.2, TP501.1 (1_1), U502.1 (+VIN)
+15V: C506.2, C507.2, C509.1, R507.2, TP507.1 (1_1), U501.2 (Vin), U503.8 (V+), U504.8 (V+), U505.6 (+VOUT); also elsewhere on the board
-15V: C503.1, C504.1, C508.1, D505.1 (K), TP508.1 (1_1), U503.4 (V-), U504.4 (V-), U505.4 (-VOUT); also elsewhere on the board
/+10V_Ref: R506.1, TP503.1 (1_1), U503.1, U503.2 (-); also elsewhere on the board
/-10V_Ref: R504.2, R506.3, TP504.1 (1_1), U503.7; also elsewhere on the board
/Connectors, Auxillaries, and References/V_Fdbk1: J505.1, J506.3
/Connectors, Auxillaries, and References/V_Fdbk2: J505.3, J506.4
/Ext_Cmd: J502.1, TP511.1 (1_1); also elsewhere on the board
/G_Lower_Cmd: J503.03 (D+), TP510.1 (1_1); also elsewhere on the board
/G_Upper_Cmd: J503.02 (D-), TP509.1 (1_1); also elsewhere on the board
/I_Fdbk_Raw: J506.5; also elsewhere on the board
/Int_Cmd: TP522.1 (1_1), U504.6 (-), U504.7; also elsewhere on the board
/V_Fdbk_Raw: J505.2; also elsewhere on the board
GND: C501.2, C502.1, C503.2, C504.2, C505.2, C506.1, C507.1, C508.2, C509.2, C510.2, C511.2, D501.1 (K), D502.1 (K), D503.1 (K), D504.1 (K), J501.B, J501.C, J502.2, J502.3, J502.4, J502.5, J503.04 (GND), J503.S1 (SHIELD), J503.S2 (SHIELD__1), J506.1, J506.2, J506.6, R508.2, TP506.1 (1_1), TP512.1 (1_1), TP513.1 (1_1), TP514.1 (1_1), TP515.1 (1_1), TP516.1 (1_1), TP517.1 (1_1), TP518.1 (1_1), TP519.1 (1_1), TP520.1 (1_1), TP521.1 (1_1), U501.4 (GND), U502.2 (GND), U503.5 (+), U504.3 (+), U505.2 (-VIN(GND)), U505.5 (COMMON), U506.1 (GND); also elsewhere on the board
unnamed: D501.2 (A), R501.1
unnamed: D502.2 (A), R503.1
unnamed: D503.2 (A), R505.1
unnamed: D504.2 (A), R507.1
unnamed: D505.2 (A), R508.1
unnamed: C502.2, U501.8 (NR)
unnamed: R502.1, TP502.1 (1_1), U501.6 (Vout), U503.3 (+)
unnamed: R502.2, R504.1, U503.6 (-)
unnamed: U504.1, U504.2 (-)
unnamed: R506.2, U504.5 (+)

Notes on the sheet:
POWER RAIL INDICATOR LEDS
Adjustable Internal Ref
unused OpAmp 504A on TL082 Dual Package
EXTRA GND TEST POINTS
+3.3V Power Indicator
+5V to ±15V
+10V Reference Generation
+9V TO +5V
POWER AND REFERENCE MANAGEMENT
+9V Input Indicator
9V INPUT DCDC CONVERSION MAIN BOARD POWER RAILS : +5V ±15V
VOLTAGE REFERENCE GENERATION
+15V Power Indicator
V_Fdbk selection
! NON-STANDARD USB WIRING ! DO NOT CONNECT THIS PORT TO STANDARD USB HOSTS OR DEVICES The USB-B shell is wired with a custom, non-standard pinout. Plugging in standard USB cables or devices may cause permanent hardware damage
+5V Power Indicator
WIRE TO BOARD INTERFACES
USB B Port Output
-15V Power Indicator
V and I feedback input header
Ext_Cmd BNC
5V to 3.3V LDO

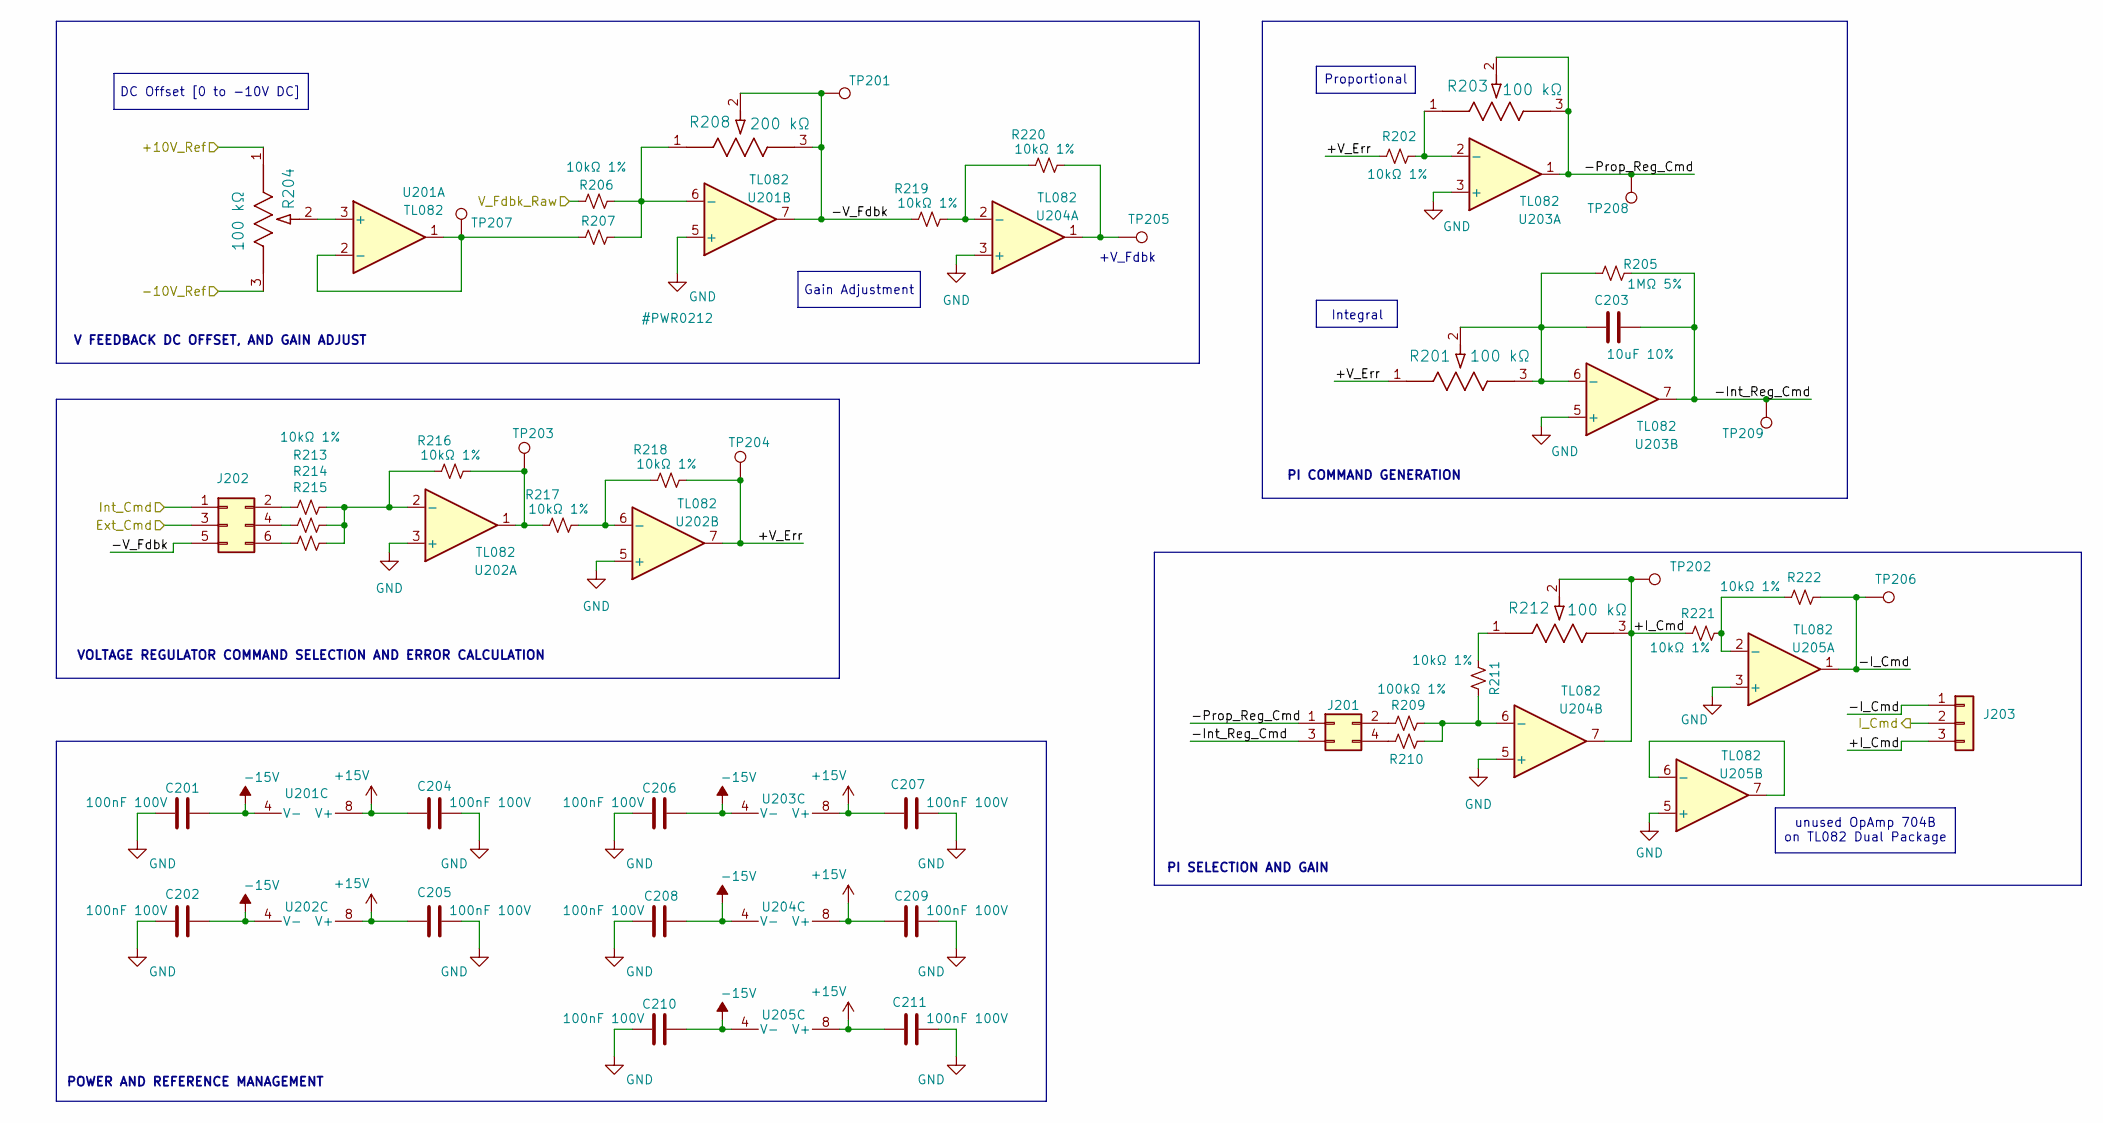
[picture p24: schematic VR.kicad_sch, HB Drive V3]

Parts:
C201, C202, C204, C205, C206, C207, C208, C209, C210, C211: 100nF 100V; C_0603_1608Metric
C203: 10uF 10%; C_0603_1608Metric
J201: Conn_02x02_Odd_Even; PinHeader_2x02_P2.54mm_Vertical
J202: Conn_02x03_Odd_Even; PinHeader_2x03_P2.54mm_Vertical
J203: Conn_01x03; PinHeader_1x03_P2.54mm_Vertical
R201, R203, R204, R212: 100 kΩ; POT_PV36W_BRN
R202, R206, R207, R210, R211, R213, R214, R215, R216, R217, R218, R219, R220, R221, R222: 10kΩ 1%; R_0603_1608Metric_Pad0.98x0.95mm_HandSolder
R205: 1MΩ 5%; R_0603_1608Metric_Pad0.98x0.95mm_HandSolder
R208: 200 kΩ; POT_PV36W_BRN
R209: 100kΩ 1%; R_0603_1608Metric_Pad0.98x0.95mm_HandSolder
TP201, TP202, TP203, TP204, TP205, TP206, TP207, TP208, TP209: TestPoint; TestPoint_Loop_D2.60mm_Drill1.6mm_Beaded
U201, U202, U203, U204, U205: TL082; SOIC-8_3.9x4.9mm_P1.27mm

Connections:
+15V: C204.2, C205.2, C207.2, C209.2, C211.2, U201.8 (V+), U202.8 (V+), U203.8 (V+), U204.8 (V+), U205.8 (V+); also elsewhere on the board
-15V: C201.1, C202.1, C206.1, C208.1, C210.1, U201.4 (V-), U202.4 (V-), U203.4 (V-), U204.4 (V-), U205.4 (V-); also elsewhere on the board
/+10V_Ref: R204.1; also elsewhere on the board
/-10V_Ref: R204.3; also elsewhere on the board
/Ext_Cmd: J202.3; also elsewhere on the board
/Inner Current Regulator/I_Cmd: J203.2; also elsewhere on the board
/Int_Cmd: J202.1; also elsewhere on the board
/Outer Voltage Regulator/+I_Cmd: J203.3, R212.2, R212.3, R221.2, TP202.1 (1_1), U204.7
/Outer Voltage Regulator/+V_Err: R201.1, R202.1, R218.1, TP204.1 (1_1), U202.7
/Outer Voltage Regulator/-I_Cmd: J203.1, R222.1, TP206.1 (1_1), U205.1
/Outer Voltage Regulator/-Int_Reg_Cmd: C203.1, J201.3, R205.2, TP209.1 (1_1), U203.7
/Outer Voltage Regulator/-Prop_Reg_Cmd: J201.1, R203.2, R203.3, TP208.1 (1_1), U203.1
/Outer Voltage Regulator/-V_Fdbk: J202.5, R208.2, R208.3, R219.2, TP201.1 (1_1), U201.7
/V_Fdbk_Raw: R206.2; also elsewhere on the board
GND: C201.2, C202.2, C204.1, C205.1, C206.2, C207.1, C208.2, C209.1, C210.2, C211.1, U201.5 (+), U202.3 (+), U202.5 (+), U203.3 (+), U203.5 (+), U204.3 (+), U204.5 (+), U205.3 (+), U205.5 (+); also elsewhere on the board
unnamed: J201.2, R209.2
unnamed: J201.4, R210.1
unnamed: J202.2, R213.2
unnamed: J202.4, R214.1
unnamed: J202.6, R215.1
unnamed: R211.2, R212.1
unnamed: R216.1, R217.2, TP203.1 (1_1), U202.1
unnamed: R220.1, TP205.1 (1_1), U204.1
unnamed: R204.2, U201.3 (+)
unnamed: R207.2, TP207.1 (1_1), U201.1, U201.2 (-)
unnamed: R206.1, R207.1, R208.1, U201.6 (-)
unnamed: R213.1, R214.2, R215.2, R216.2, U202.2 (-)
unnamed: R217.1, R218.2, U202.6 (-)
unnamed: R202.2, R203.1, U203.2 (-)
unnamed: C203.2, R201.2, R201.3, R205.1, U203.6 (-)
unnamed: R219.1, R220.2, U204.2 (-)
unnamed: R209.1, R210.2, R211.1, U204.6 (-)
unnamed: R221.1, R222.2, U205.2 (-)
unnamed: U205.6 (-), U205.7

Notes on the sheet:
PI SELECTION AND GAIN
Proportional
Gain Adjustment
DC Offset [0 to -10V DC]
unused OpAmp 704B on TL082 Dual Package
VOLTAGE REGULATOR COMMAND SELECTION AND ERROR CALCULATION
V FEEDBACK DC OFFSET, AND GAIN ADJUST
Integral
+V_Fdbk
PI COMMAND GENERATION
POWER AND REFERENCE MANAGEMENT

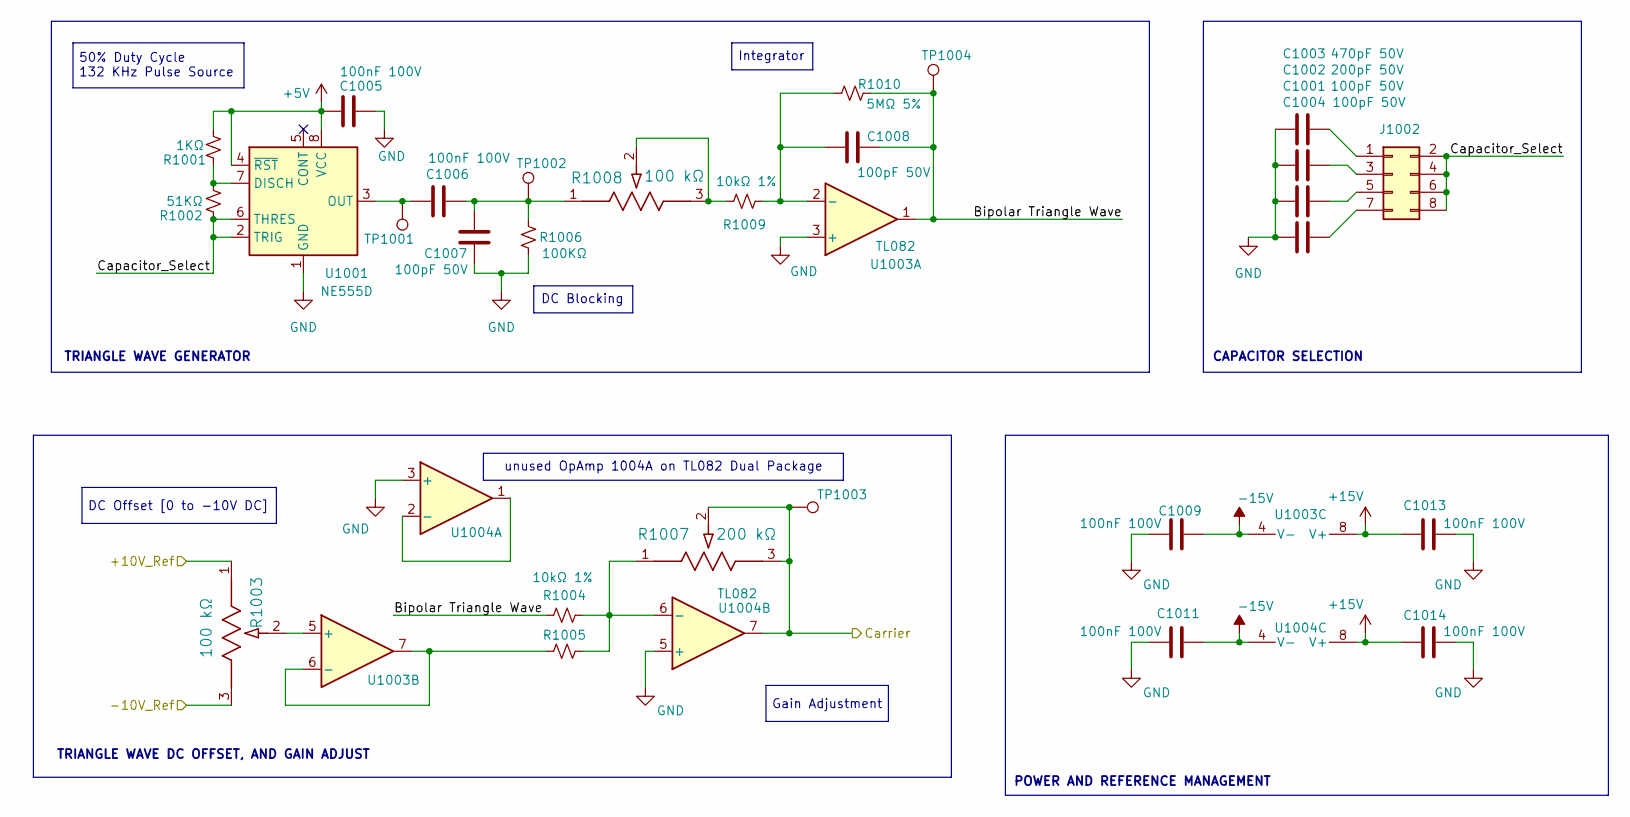
[picture p25: schematic Carrier.kicad_sch, HB Drive V3]

Parts:
C1001, C1004, C1007, C1008: 100pF 50V; C_0603_1608Metric
C1002: 200pF 50V; C_0603_1608Metric
C1003: 470pF 50V; C_0603_1608Metric
C1005, C1006, C1009, C1011, C1013, C1014: 100nF 100V; C_0603_1608Metric
J1002: Conn_02x04_Odd_Even; PinHeader_2x04_P2.54mm_Vertical
R1001: 1KΩ; R_0603_1608Metric_Pad0.98x0.95mm_HandSolder
R1002: 51KΩ; R_0603_1608Metric_Pad0.98x0.95mm_HandSolder
R1003, R1008: 100 kΩ; POT_PV36W_BRN
R1004, R1005, R1009: 10kΩ 1%; R_0603_1608Metric_Pad0.98x0.95mm_HandSolder
R1006: 100KΩ; R_0603_1608Metric_Pad0.98x0.95mm_HandSolder
R1007: 200 kΩ; POT_PV36W_BRN
R1010: 5MΩ 5%; R_0603_1608Metric_Pad0.98x0.95mm_HandSolder
TP1001, TP1002, TP1003, TP1004: TestPoint; TestPoint_Loop_D2.60mm_Drill1.6mm_Beaded
U1001: NE555D; SOIC-8_3.9x4.9mm_P1.27mm
U1003, U1004: TL082; SOIC-8_3.9x4.9mm_P1.27mm

Connections:
+5V: C1005.2, R1001.1, U1001.4 (~RST), U1001.8 (VCC); also elsewhere on the board
+15V: C1013.2, C1014.2, U1003.8 (V+), U1004.8 (V+); also elsewhere on the board
-15V: C1009.1, C1011.1, U1003.4 (V-), U1004.4 (V-); also elsewhere on the board
/+10V_Ref: R1003.1; also elsewhere on the board
/-10V_Ref: R1003.3; also elsewhere on the board
/Modulator and Protection/Carrier Wave/Bipolar Triangle Wave: C1008.2, R1004.2, R1010.2, TP1004.1 (1_1), U1003.1
/Modulator and Protection/Carrier Wave/Capacitor_Select: J1002.2, J1002.4, J1002.6, J1002.8, R1002.2, U1001.2 (TRIG), U1001.6 (THRES)
/Modulator and Protection/Carrier Wave/Carrier: R1007.2, R1007.3, TP1003.1 (1_1), U1004.7; also elsewhere on the board
GND: C1001.2, C1002.2, C1003.2, C1004.2, C1005.1, C1007.2, C1009.2, C1011.2, C1013.1, C1014.1, R1006.2, U1001.1 (GND), U1003.3 (+), U1004.3 (+), U1004.5 (+); also elsewhere on the board
unnamed: C1006.1, C1007.1, R1006.1, R1008.1, TP1002.1 (1_1)
unnamed: C1003.1, J1002.1
unnamed: C1002.1, J1002.3
unnamed: C1001.1, J1002.5
unnamed: C1004.1, J1002.7
unnamed: R1008.2, R1008.3, R1009.1
unnamed: R1001.2, R1002.1, U1001.7 (DISCH)
unnamed: C1006.2, TP1001.1 (1_1), U1001.3 (OUT)
unnamed: C1008.1, R1009.2, R1010.1, U1003.2 (-)
unnamed: R1003.2, U1003.5 (+)
unnamed: R1005.2, U1003.6 (-), U1003.7
unnamed: U1004.1, U1004.2 (-)
unnamed: R1004.1, R1005.1, R1007.1, U1004.6 (-)

Notes on the sheet:
CAPACITOR SELECTION
TRIANGLE WAVE GENERATOR
DC Blocking
unused OpAmp 1004A on TL082 Dual Package
TRIANGLE WAVE DC OFFSET, AND GAIN ADJUST
50% Duty Cycle 132 KHz Pulse Source
DC Offset [0 to -10V DC]
Gain Adjustment
POWER AND REFERENCE MANAGEMENT
Integrator

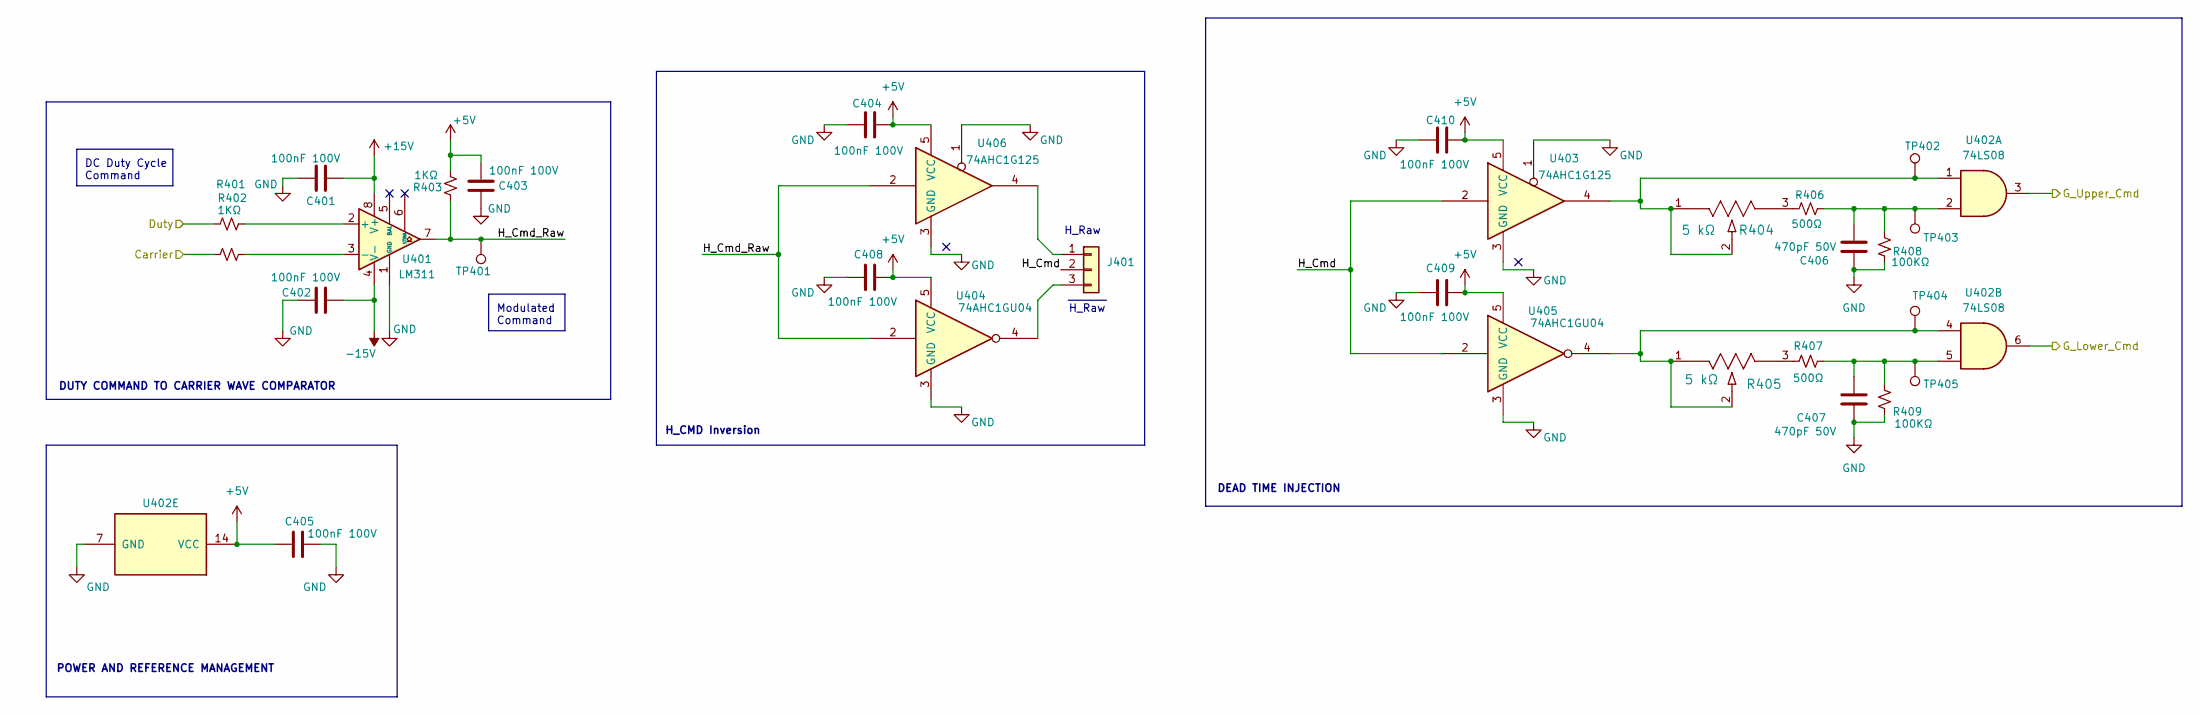
[picture p26: schematic ModAndDead.kicad_sch, HB Drive V3]

Parts:
C401, C402, C403, C404, C405, C408, C409, C410: 100nF 100V; C_0603_1608Metric
C406, C407: 470pF 50V; C_0603_1608Metric
J401: Conn_01x03; PinHeader_1x03_P2.54mm_Vertical
R401, R402, R403: 1KΩ; R_0603_1608Metric_Pad0.98x0.95mm_HandSolder
R404, R405: 5 kΩ; POT_PV36W_BRN
R406, R407: 500Ω; R_0603_1608Metric_Pad0.98x0.95mm_HandSolder
R408, R409: 100KΩ; R_0603_1608Metric_Pad0.98x0.95mm_HandSolder
TP401, TP402, TP403, TP404, TP405: TestPoint; TestPoint_Loop_D2.60mm_Drill1.6mm_Beaded
U401: LM311; SOIC-8_3.9x4.9mm_P1.27mm
U402: 74LS08; SOIC-14_3.9x8.7mm_P1.27mm
U403, U406: 74AHC1G125; SOT-23-5
U404, U405: 74AHC1GU04; SOT-23-5

Connections:
+5V: C403.2, C404.1, C405.2, C408.1, C409.1, C410.1, R403.2, U402.14 (VCC), U403.5 (VCC), U404.5 (VCC), U405.5 (VCC), U406.5 (VCC); also elsewhere on the board
+15V: C401.1, U401.8 (V+); also elsewhere on the board
-15V: C402.1, U401.4 (V-); also elsewhere on the board
/Modulator and Protection/Carrier Wave/Carrier: R402.1; also elsewhere on the board
/Modulator and Protection/Modulator and Dead Time Injector/Duty: R401.1; also elsewhere on the board
/Modulator and Protection/Modulator and Dead Time Injector/G_Lower_Cmd: U402.6; also elsewhere on the board
/Modulator and Protection/Modulator and Dead Time Injector/G_Upper_Cmd: U402.3; also elsewhere on the board
/Modulator and Protection/Modulator and Dead Time Injector/H_Cmd: J401.2, U403.2, U405.2
/Modulator and Protection/Modulator and Dead Time Injector/H_Cmd_Raw: R403.1, TP401.1 (1_1), U401.7, U404.2, U406.2
GND: C401.2, C402.2, C403.1, C404.2, C405.1, C406.2, C407.2, C408.2, C409.2, C410.2, R408.2, R409.2, U401.1 (GND), U402.7 (GND), U403.1, U403.3 (GND), U404.3 (GND), U405.3 (GND), U406.1, U406.3 (GND); also elsewhere on the board
unnamed: C406.1, R406.2, R408.1, TP403.1 (1_1), U402.2
unnamed: C407.1, R407.2, R409.1, TP405.1 (1_1), U402.5
unnamed: J401.1, U406.4
unnamed: J401.3, U404.4
unnamed: R404.1, R404.2, TP402.1 (1_1), U402.1, U403.4
unnamed: R404.3, R406.1
unnamed: R405.1, R405.2, TP404.1 (1_1), U402.4, U405.4
unnamed: R405.3, R407.1
unnamed: R401.2, U401.2 (+)
unnamed: R402.2, U401.3 (-)

Notes on the sheet:
DUTY COMMAND TO CARRIER WAVE COMPARATOR
DEAD TIME INJECTION
H_Raw
H_CMD Inversion
DC Duty Cycle Command
Modulated Command
POWER AND REFERENCE MANAGEMENT
