MPstoughton/HB-Drive/HB_Drive_V1/HB_Drive_V1.kicad_pcb

## KiCad design HB_Drive_V1/HB_Drive_V1.kicad_pcb (continued)

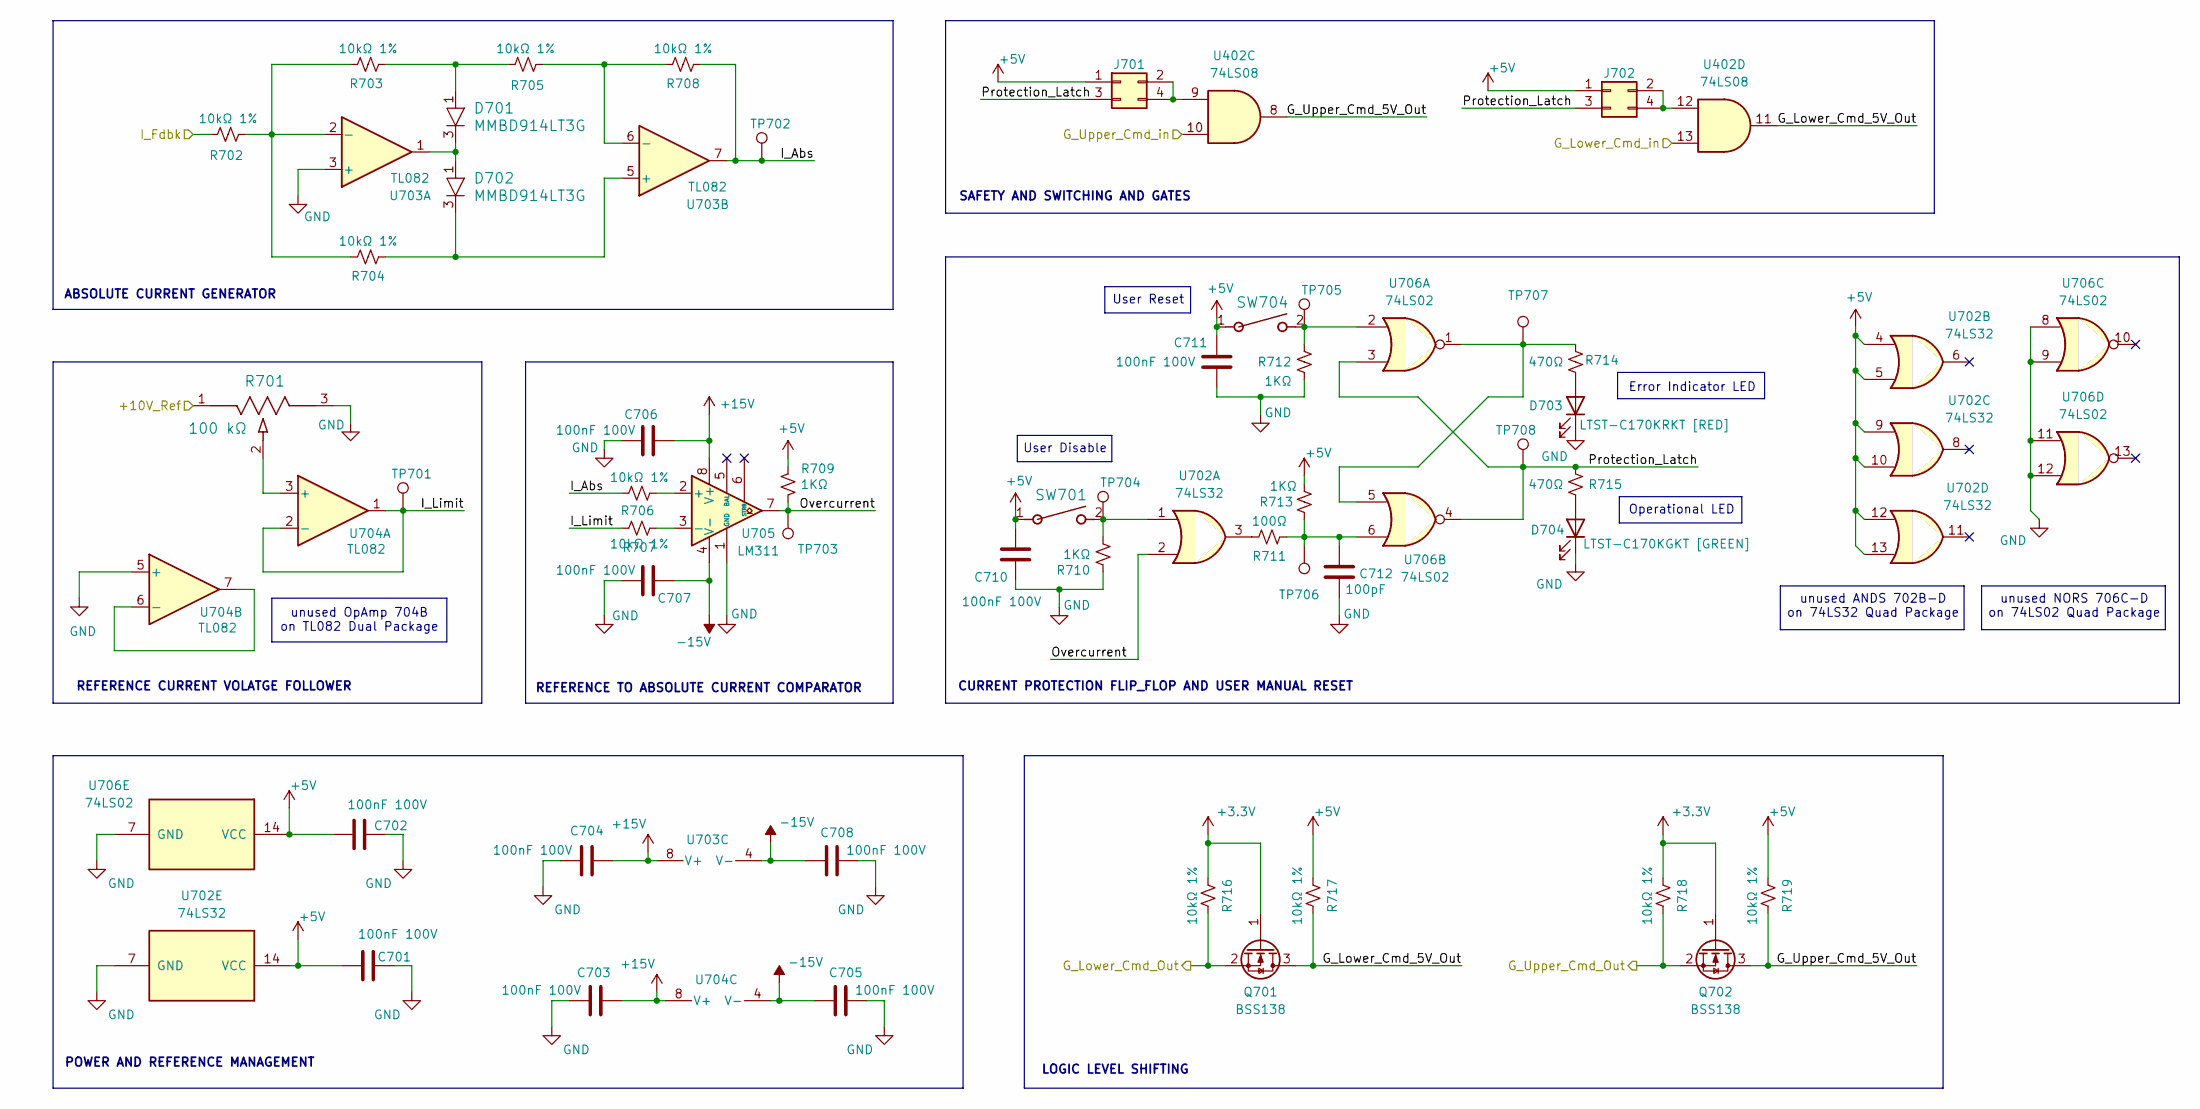
[picture p27: schematic Protection.kicad_sch, HB Drive V3]

Parts:
C701, C702, C703, C704, C705, C706, C707, C708, C710, C711: 100nF 100V; C_0603_1608Metric
C712: 100pF; C_0603_1608Metric
D701, D702: MMBD914LT3G; SOT-23_ONS
D703: LTST-C170KRKT [RED]; LED_0805_2012Metric_Pad1.15x1.40mm_HandSolder
D704: LTST-C170KGKT [GREEN]; LED_0805_2012Metric_Pad1.15x1.40mm_HandSolder
J701, J702: Conn_02x02_Odd_Even; PinHeader_2x02_P2.54mm_Vertical
Q701, Q702: BSS138; SOT-23
R701: 100 kΩ; POT_PV36W_BRN
R702, R703, R704, R705, R706, R707, R708, R716, R717, R718, R719: 10kΩ 1%; R_0603_1608Metric_Pad0.98x0.95mm_HandSolder
R709, R710, R712, R713: 1KΩ; R_0603_1608Metric_Pad0.98x0.95mm_HandSolder
R711: 100Ω; R_0603_1608Metric_Pad0.98x0.95mm_HandSolder
R714, R715: 470Ω; R_0603_1608Metric_Pad0.98x0.95mm_HandSolder
SW701, SW704: PTS636SL43SMTRLFS
TP701, TP702, TP703, TP704, TP705, TP706, TP707, TP708: TestPoint; TestPoint_Loop_D2.60mm_Drill1.6mm_Beaded
U402: 74LS08; SOIC-14_3.9x8.7mm_P1.27mm
U702: 74LS32; SOIC-14_3.9x8.7mm_P1.27mm
U703, U704: TL082; SOIC-8_3.9x4.9mm_P1.27mm
U705: LM311; SOIC-8_3.9x4.9mm_P1.27mm
U706: 74LS02; SOIC-14_3.9x8.7mm_P1.27mm

Connections:
+3.3V: Q701.1 (G), Q702.1 (G), R716.2, R718.2; also elsewhere on the board
+5V: C701.2, C702.2, C710.1, C711.1, J701.1, J702.1, R709.2, R713.2, R717.2, R719.2, SW701.1, SW704.1, U702.4, U702.5, U702.9, U702.10, U702.12, U702.13, U702.14 (VCC), U706.14 (VCC); also elsewhere on the board
+15V: C703.1, C704.1, C706.1, U703.8 (V+), U704.8 (V+), U705.8 (V+); also elsewhere on the board
-15V: C705.2, C707.1, C708.2, U703.4 (V-), U704.4 (V-), U705.4 (V-); also elsewhere on the board
/+10V_Ref: R701.1; also elsewhere on the board
/G_Lower_Cmd: Q701.2 (S), R716.1; also elsewhere on the board
/G_Upper_Cmd: Q702.2 (S), R718.1; also elsewhere on the board
/Inner Current Regulator/-I_Fdbk: R702.1; also elsewhere on the board
/Modulator and Protection/Modulator and Dead Time Injector/G_Lower_Cmd: U402.13; also elsewhere on the board
/Modulator and Protection/Modulator and Dead Time Injector/G_Upper_Cmd: U402.10; also elsewhere on the board
/Modulator and Protection/Protection/G_Lower_Cmd_5V_Out: Q701.3 (D), R717.1, U402.11
/Modulator and Protection/Protection/G_Upper_Cmd_5V_Out: Q702.3 (D), R719.1, U402.8
/Modulator and Protection/Protection/I_Abs: R706.1, R708.2, TP702.1 (1_1), U703.7
/Modulator and Protection/Protection/I_Limit: R707.2, TP701.1 (1_1), U704.1, U704.2 (-)
/Modulator and Protection/Protection/Overcurrent: R709.1, TP703.1 (1_1), U702.2, U705.7
/Modulator and Protection/Protection/Protection_Latch: J701.3, J702.3, R715.2, TP708.1 (1_1), U706.3, U706.4
GND: C701.1, C702.1, C703.2, C704.2, C705.1, C706.2, C707.2, C708.1, C710.2, C711.2, C712.1, D703.1 (K), D704.1 (K), R701.3, R710.1, R712.1, U702.7 (GND), U703.3 (+), U704.5 (+), U705.1 (GND), U706.7 (GND), U706.8, U706.9, U706.11, U706.12; also elsewhere on the board
unnamed: C712.2, R711.2, R713.1, TP706.1 (1_1), U706.6
unnamed: D701.1, R703.2, R705.1
unnamed: D701.3, D702.1, U703.1
unnamed: D703.2 (A), R714.1
unnamed: D704.2 (A), R715.1
unnamed: J701.2, J701.4, U402.9
unnamed: J702.2, J702.4, U402.12
unnamed: R710.2, SW701.2, TP704.1 (1_1), U702.1
unnamed: R711.1, U702.3
unnamed: R712.2, SW704.2, TP705.1 (1_1), U706.2
unnamed: R714.2, TP707.1 (1_1), U706.1, U706.5
unnamed: R702.2, R703.1, R704.1, U703.2 (-)
unnamed: D702.3, R704.2, U703.5 (+)
unnamed: R705.2, R708.1, U703.6 (-)
unnamed: R701.2, U704.3 (+)
unnamed: U704.6 (-), U704.7
unnamed: R706.2, U705.2 (+)
unnamed: R707.1, U705.3 (-)

Notes on the sheet:
Operational LED
CURRENT PROTECTION FLIP_FLOP AND USER MANUAL RESET
SAFETY AND SWITCHING AND GATES
User Reset
ABSOLUTE CURRENT GENERATOR
POWER AND REFERENCE MANAGEMENT
LOGIC LEVEL SHIFTING
Error Indicator LED
unused NORS 706C-D on 74LS02 Quad Package
REFERENCE CURRENT VOLATGE FOLLOWER
REFERENCE TO ABSOLUTE CURRENT COMPARATOR
User Disable
unused ANDS 702B-D on 74LS32 Quad Package
unused OpAmp 704B on TL082 Dual Package

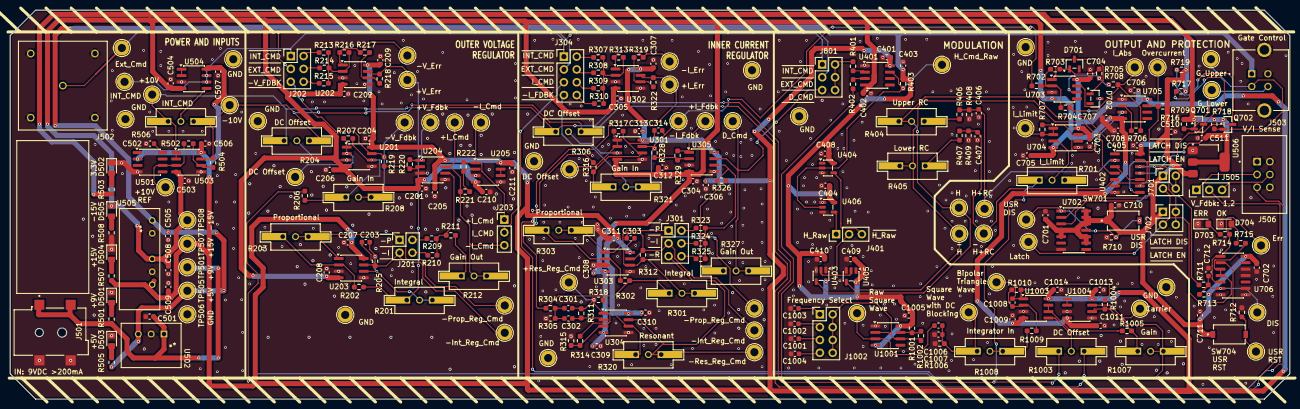
[picture p28: board HB_Drive_V1.kicad_pcb from above]

Board: 2 copper layers, 253.2 x 77.0 mm, 282 parts (0 on the bottom side), 137 nets.
