MPstoughton/HB-Drive/(commit log)

2026-06-11 Initial KiCad project setup
    [HB_Drive_V1.kicad_pcb, HB_Drive_V1.kicad_sch]
2026-06-11 Adds Preliminary Hierarchical Schematics
    [Comparator.kicad_sch, CurrentMonitor.kicad_sch, DeadTime.kicad_sch, HB_Drive_V1.kicad_sch, IR.kicad_sch, TriWaveGen.kicad_sch, VR.kicad_sch]
2026-06-12 fixes git and adds a first revision of the Inner Current Regulator (NOT COMPLETE)
    [Carrier.kicad_sch, CurrentMonitor.kicad_sch, DeadTime.kicad_sch, HB_Drive_V1.kicad_pcb, HB_Drive_V1.kicad_sch, IR.kicad_sch, Modulator.kicad_sch, POT_PV36W_BRN.step]
2026-06-12 Finishes first revision of the Inner Current Regulator!
    [IR.kicad_sch]
2026-06-15 Adds Carrier Wave Circuit and Comparator Circuit
    [Carrier.kicad_sch, Comparator.kicad_sch, IR.kicad_sch, Modulator.kicad_sch]
2026-06-16 Notes from conversation PF + MS
    [Carrier.kicad_sch, DeadTime.kicad_sch, IR.kicad_sch, Modulator.kicad_sch]
2026-06-23 adds 10v reference and DC offsets / gain control to I_fdbk and V_fdbk
    [54-00164.step, Carrier.kicad_sch, Comparator.kicad_sch, CurrentMonitor.kicad_sch, DeadTime.kicad_sch, HB_Drive_V1.kicad_pcb, HB_Drive_V1.kicad_sch, IR.kicad_sch]
2026-07-01 finishes hirearchical labels, add 10v +- ref generation and updates the DC offset circuits
    [Carrier.kicad_sch, Comparator.kicad_sch, DeadTime.kicad_sch, HB_Drive_V1.kicad_pcb, HB_Drive_V1.kicad_sch, IR.kicad_sch, Modulator.kicad_sch, Protection.kicad_sch]
2026-07-03 updates board to highest working copy
    [5227699-1.step, Carrier.kicad_sch, Comparator.kicad_sch, HB_Drive_V1.csv, HB_Drive_V1.kicad_pcb, HB_Drive_V1.kicad_sch, IR.kicad_sch, ModAndDead.kicad_sch]
2026-07-03 removes Aux file trouble
    [Connectors.kicad_sch, HB_Drive_V1.kicad_sch, IR.kicad_sch, Modulator.kicad_sch, Protection.kicad_sch]
2026-07-07 commits latest kiCAD project for BOM generation
    [Connectors.kicad_sch, HB_Drive_V1.kicad_pcb, ModAndDead.kicad_sch, PTS636SL43SMTRLFS.step, Protection.kicad_sch]
2026-07-22 updates board to REV 1 Ordered version
    [Carrier.kicad_sch, Connectors.kicad_sch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]
2026-08-12 Annotates Schematic! Fixes REV1 wiring swaps and replaces buffer
    [Carrier.kicad_sch, Connectors.kicad_sch, HB_Drive_V1.kicad_pcb, HB_Drive_V1.kicad_sch, IR.kicad_sch, ModAndDead.kicad_sch, Modulator.kicad_sch, Protection.kicad_sch]
2026-08-12 annotates PCB! wiring is still broken here
    [30306-6002HB.step, Connectors.kicad_sch, HB_Drive_V1.kicad_pcb, IR.kicad_sch, ModAndDead.kicad_sch, VR.kicad_sch]
2026-08-13 Preliminary wiring of V2 completed, yet to pass DRC
    [HB_Drive_V1.kicad_pcb]
2026-08-13 Preliminary wiring of V2, Passes DRC, awaiting review
    [HB_Drive_V1.kicad_pcb]
2026-08-17 Updates to 1st review corrected V2 of board
    [Carrier.kicad_sch, Connectors.kicad_sch, HB_Drive_V1.kicad_pcb, HB_Drive_V2.csv, IR.kicad_sch]
2026-08-26 restores v2 to condtion as ordered!
    [Carrier.kicad_sch, Connectors.kicad_sch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]
2026-09-09 Moves Ports and adds level shifter
    [Connectors.kicad_sch, HB_Drive_V1.kicad_pcb, Protection.kicad_sch]
2026-10-09 Brings everything up to latest copy on my computer
    [Carrier.kicad_sch, Connectors.kicad_sch, HB_Drive_V1-Edge_Cuts.dxf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]
2026-10-09 Makes annotation changes
    [Carrier.kicad_sch, IR.kicad_sch, ModAndDead.kicad_sch, Protection.kicad_sch, VR.kicad_sch]
