MPstoughton/HB-Drive/(notices)

Notices in the files:
HB_Drive_V1/Custom Components/USB_B_S_VT/USB-B-S-VT.step:
author */ ('License CC BY-ND 4.0'),
